spout-task/hardware/spout_holder/README.md

# Spout holder

Small printed blocks that hold the stainless steel lick spout(s) and attach them to an optical post on
the motorized manipulator, and a laser cut plate that holds the two solenoid valves of the water line.

<p align="center">
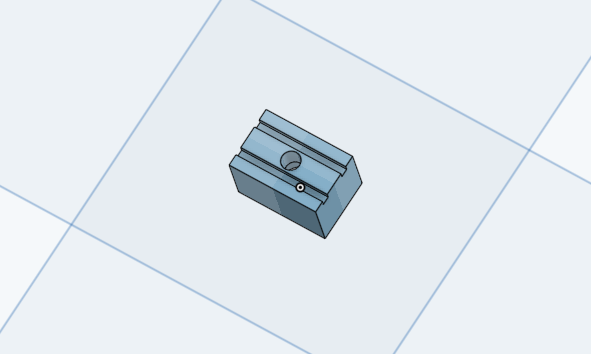
[picture p11: spout_holder/design/pictures/water_spout_bottom_mount.png]
Bottom mount spout holder
  
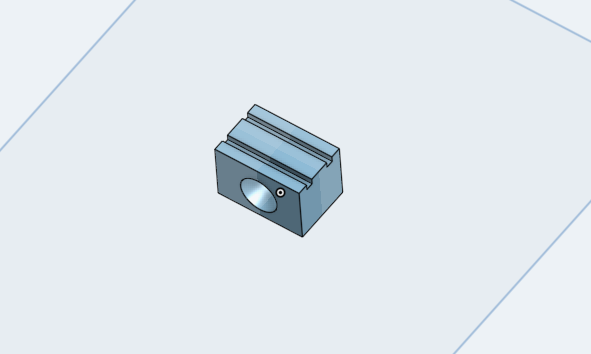
[picture p12: spout_holder/design/pictures/water_spout_side_mount.png]
Side mount spout holder
  
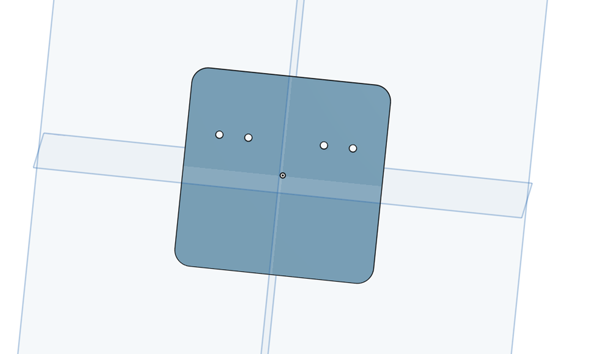
[picture p13: spout_holder/design/pictures/dual_solenoid_holder.png]
Dual solenoid holder
  
</p>

## At a glance

| | |
|---|---|
| Function | Holds one or two lick spouts in front of the mouse, and the two solenoid valves |
| Fabrication | Spout holders 3D printed (Prusa MK3, PLA, standard settings); solenoid holder laser cut from 1/8 inch acrylic |
| Used by | SPOUT1 and SPOUT2 (bottom mount); side mount for tight setups |

## Files

All design files are in [`design/files`](design/files/) and renders in [`design/pictures`](design/pictures/).

| Part | Files | What it is | How we made it |
|---|---|---|---|
| Bottom mount spout holder | [`.stl`](design/files/water_spout_bottom_mount.stl), [`.step`](design/files/water_spout_bottom_mount.step) | Holder mounted from below; used on SPOUT1 and SPOUT2 rigs | 3D printed, PLA |
| Side mount spout holder | [`.stl`](design/files/water_spout_side_mount.stl), [`.step`](design/files/water_spout_side_mount.step) | Holder mounted from the side, for setups with little space | 3D printed, PLA |
| Dual solenoid holder | [`.dxf`](design/files/dual_solenoid_holder.dxf), [`.stl`](design/files/dual_solenoid_holder.stl), [`.step`](design/files/dual_solenoid_holder.step) | Plate that holds the two solenoid valves | Laser cut, 1/8 inch acrylic |

The solenoid holder can also be 3D printed from the STL file. The STEP file is for editing in CAD.

## Bill of materials (water delivery)

| Qty | Part | Supplier | Part number | Price (USD) |
|---|---|---|---|---|
| 1 | 3D printed spout holder | | | |
| 1 | Stainless steel tube for the spouts | McMaster-Carr | 5560K72 | 3.90 |
| 2 | Syringe 30 ml (water reservoir) | BD Medical | 302832 | 0.32 each |
| 2 | Syringe 5 ml (flushing) | BD Medical | 309646 | 0.18 each |
| 2 | 3 way valve | Cole Parmer | 48523-38 | 1.01 each |
| 2 | Solenoid valve, 5 V | The Lee Company | LHQA0531220H | 65.60 each |
| 10 | Tubing, ID 1/16 inch, OD 1/8 inch | Tygon | E-3603 | 0.28 each |
| 1 | Pedestal post holder | Thorlabs | PH1 | 8.74 |
| 1 | Optical post | Thorlabs | TR6 | 8.66 |
| 2 | Cage rods | Thorlabs | ER3-P4 | 7.26 each |
| 1 | Swivel post | Thorlabs | MSWC | 40.80 |
| 1 | Dual solenoid holder, laser cut 1/8 inch acrylic | | | |

Full list: [`SPOUT_BOM.xlsx`](../SPOUT_BOM.xlsx).

## Assembly

1. Solder a wire to each stainless steel tube (spout), which will pull down the current of the dual-lick detector to detect licks. Make sure to solder a banana plug to the negative terminal to connect to the tube and headplate the holds the mouse.
2. Press fit the stainless steel tubes (spouts) into the holder and secure with a little glue.
3. Mount the holder on an optical post on the [motorized manipulator](../motorized_manipulator/).
4. Mount the two solenoids on the dual solenoid holder with four 4-40 screws.
5. The solenoid connection scheme: Top connector input from 30 ml reservoir, middle connector output to spout, bottom connector close by using some tubing with a zip tie. Power (left pin facing the solenoid from the connections should go to the left PCB connector on the Teensy breakout board) should go to the Teensy breakout board SLN1 or SLN2.
6. Use the 3-way valve to connect the 5 ml syringe to one side, the 30 ml syringe to the top side, and the solenoid to the other side. The 30 ml syringe is the reservoir, the 5 ml syringe is used to flush and prepare the tubing with reward, and the 3-way valve is to switch between them.
7. Connect each spout to the [dual lick detector](../dual_lick_detector/) and each solenoid to the [Teensy breakout board](../teensy_breakout_board/).

Photos of the build process will be added.

## License
**CERN-OHL-S-2.0** ([`LICENSE`](../LICENSE)).
