spout-task/hardware/motorized_manipulator/schematics/README.md

# Motorized manipulator: schematics

Schematics of the linear stage and of the stepper motor driver and controller. Click a picture to open it at full size.

Back to the [Motorized manipulator README](../README.md).

<table>
<tr>
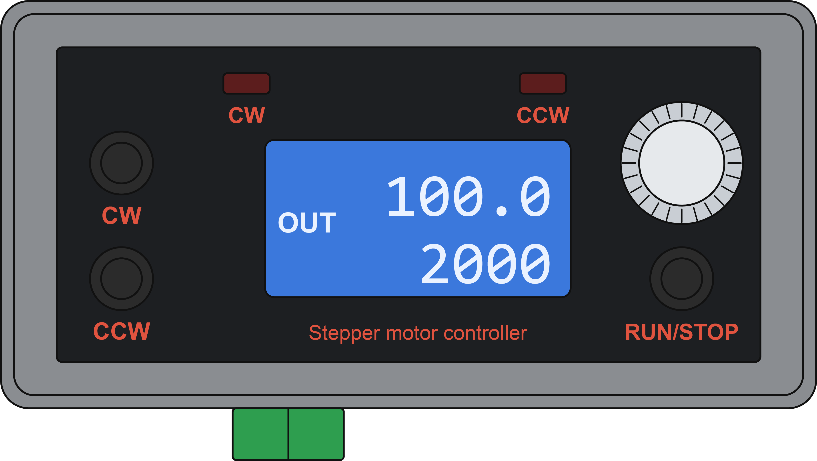
[picture p20: motorized_manipulator/schematics/driver_1.png]
Front panel of the driver and controller
<td width="50%" align="center" valign="top"><br><code>driver_1.png</code><br>Front panel of the driver and controller</td>
<td width="50%" align="center" valign="top"><a href="driver_2.png">Front panel with every button, indicator and the speed knob labelled</a><br><code>driver_2.png</code><br>Front panel with every button, indicator and the speed knob labelled</td>
</tr>
<tr>
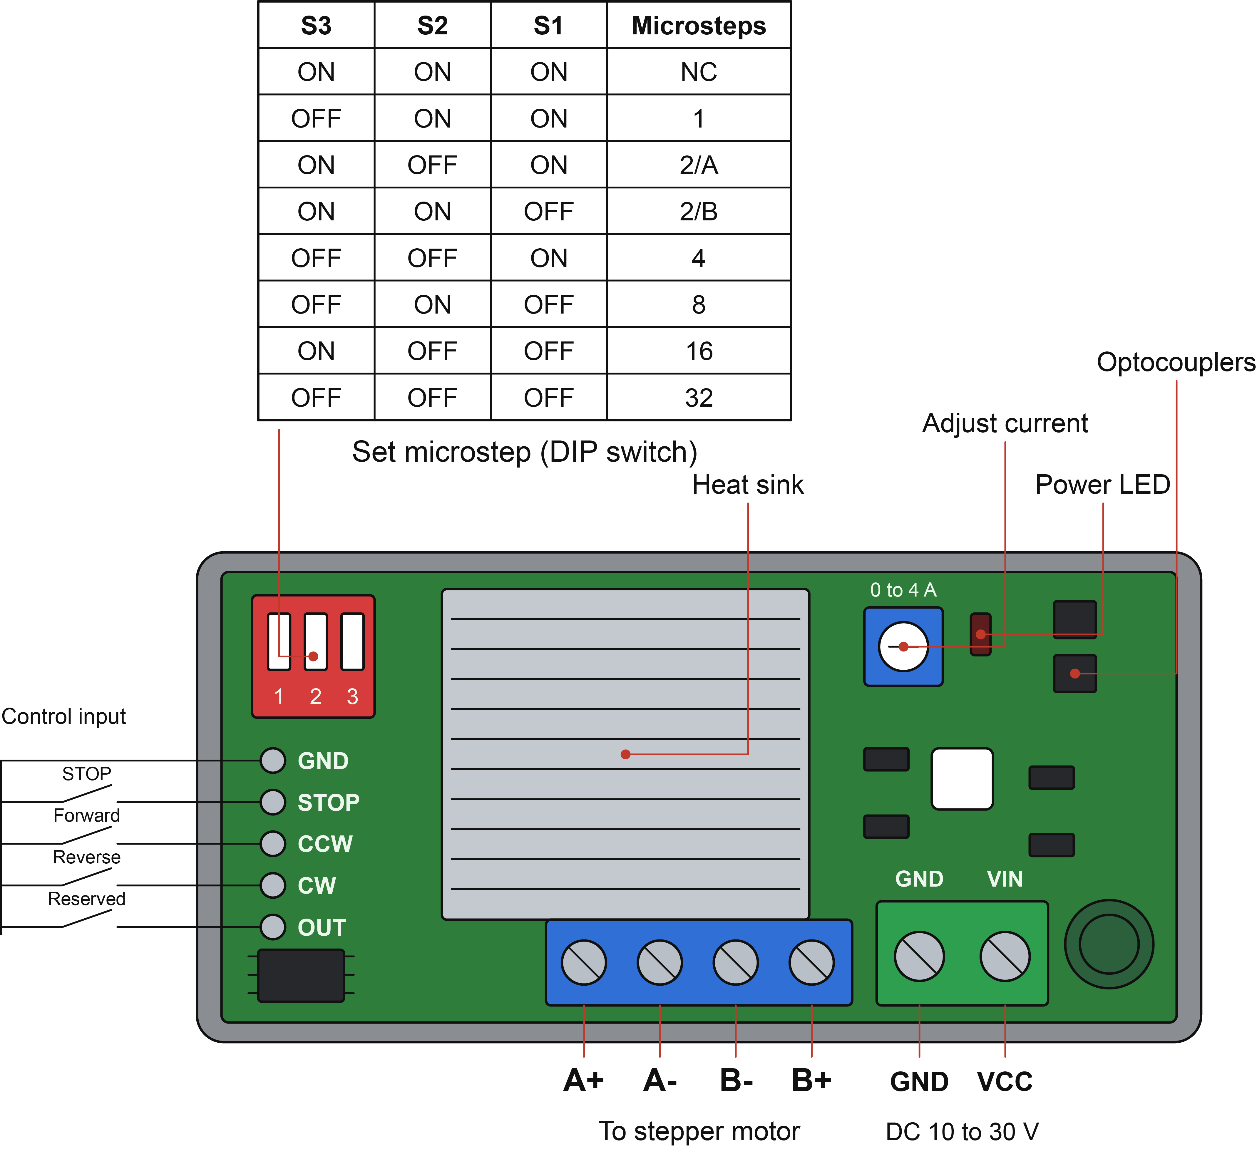
[picture p21: motorized_manipulator/schematics/driver_3.png]
Driver board: microstep DIP switch table, current adjustment, control inputs, motor and power terminals
<td width="50%" align="center" valign="top"><br><code>driver_3.png</code><br>Driver board: microstep DIP switch table, current adjustment, control inputs, motor and power terminals</td>
<td width="50%" align="center" valign="top"><a href="driver_4.png">Wiring of the stepper motor and the 24 V supply to the driver</a><br><code>driver_4.png</code><br>Wiring of the stepper motor and the 24 V supply to the driver</td>
</tr>
<tr>
<td width="50%" align="center" valign="top"><a href="track_1.png">Linear stage, top and side view with dimensions in mm</a><br><code>track_1.png</code><br>Linear stage, top and side view with dimensions in mm</td>
<td width="50%" align="center" valign="top"><a href="track_2.png">Linear stage with the stepper motor lead colors</a><br><code>track_2.png</code><br>Linear stage with the stepper motor lead colors</td>
</tr>
</table>
