spout-task/hardware/motorized_manipulator/design/pictures/README.md

# Motorized manipulator: design pictures

A photo of the assembled manipulator and renders of the 3D printed adapters, the drilling templates and the laser cut driver box. Click a picture to open it at full size.

Back to the [Motorized manipulator README](../../README.md).

## Photo

<table>
<tr>
<td width="50%" align="center" valign="top"><a href="motorized_manipulator.png">Assembled X, Y, Z manipulator with the post adapter</a><br><code>motorized_manipulator.png</code><br>Assembled X, Y, Z manipulator with the post adapter</td>
<td width="50%"></td>
</tr>
</table>

## Renders

<table>
<tr>
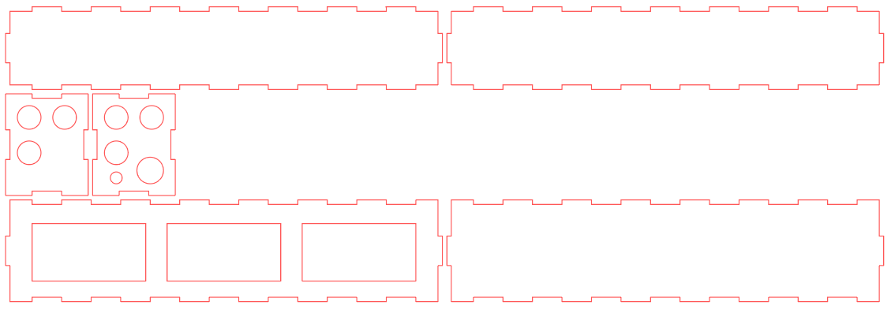
[picture p22: motorized_manipulator/design/pictures/box_mounting_steppermotor_drivers.png]
Laser cut box for the three drivers, cutting layout
<td width="50%" align="center" valign="top"><br><code>box_mounting_steppermotor_drivers.png</code><br>Laser cut box for the three drivers, cutting layout</td>
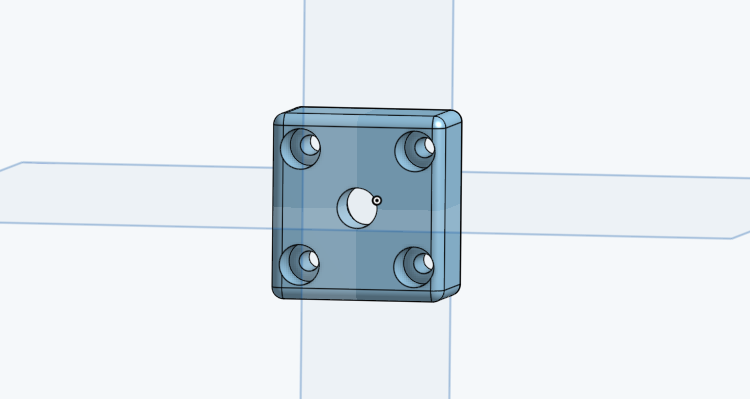
[picture p23: motorized_manipulator/design/pictures/micromanipulator_stage2postHalfInch1.png]
Adapter from the top stage to a 1/2 inch post, view 1
<td width="50%" align="center" valign="top"><br><code>micromanipulator_stage2postHalfInch1.png</code><br>Adapter from the top stage to a 1/2 inch post, view 1</td>
</tr>
<tr>
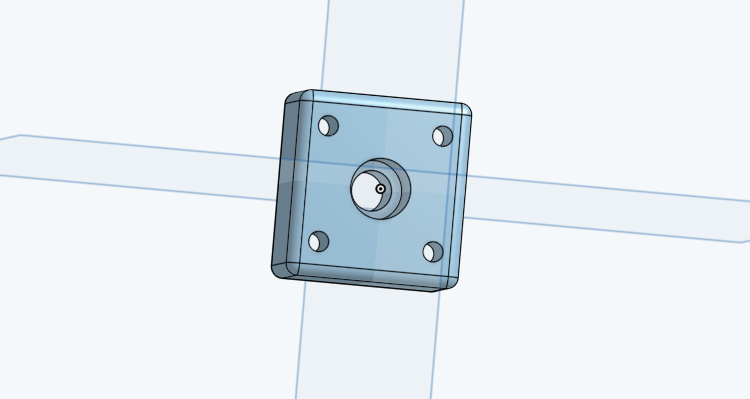
[picture p24: motorized_manipulator/design/pictures/micromanipulator_stage2postHalfInch2.png]
Adapter from the top stage to a 1/2 inch post, view 2
<td width="50%" align="center" valign="top"><br><code>micromanipulator_stage2postHalfInch2.png</code><br>Adapter from the top stage to a 1/2 inch post, view 2</td>
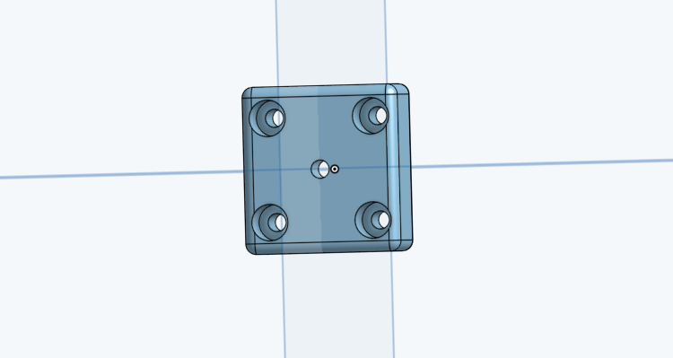
[picture p25: motorized_manipulator/design/pictures/micromanipulator_stage2postQuarterInch1.png]
Adapter from the top stage to a 1/4 inch post, view 1
<td width="50%" align="center" valign="top"><br><code>micromanipulator_stage2postQuarterInch1.png</code><br>Adapter from the top stage to a 1/4 inch post, view 1</td>
</tr>
<tr>
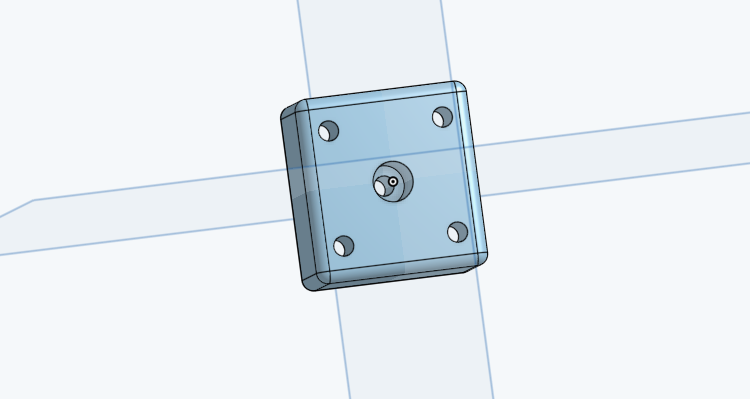
[picture p26: motorized_manipulator/design/pictures/micromanipulator_stage2postQuarterInch2.png]
Adapter from the top stage to a 1/4 inch post, view 2
<td width="50%" align="center" valign="top"><br><code>micromanipulator_stage2postQuarterInch2.png</code><br>Adapter from the top stage to a 1/4 inch post, view 2</td>
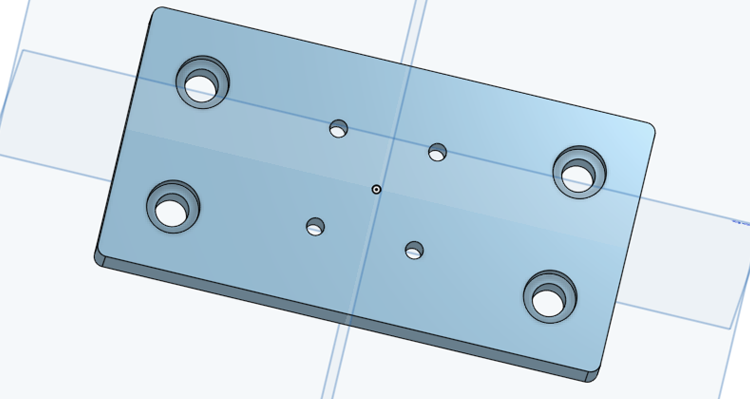
[picture p27: motorized_manipulator/design/pictures/micromanipulator_to_breadboard1.png]
Plate that mounts the bottom stage on the breadboard, view 1
<td width="50%" align="center" valign="top"><br><code>micromanipulator_to_breadboard1.png</code><br>Plate that mounts the bottom stage on the breadboard, view 1</td>
</tr>
<tr>
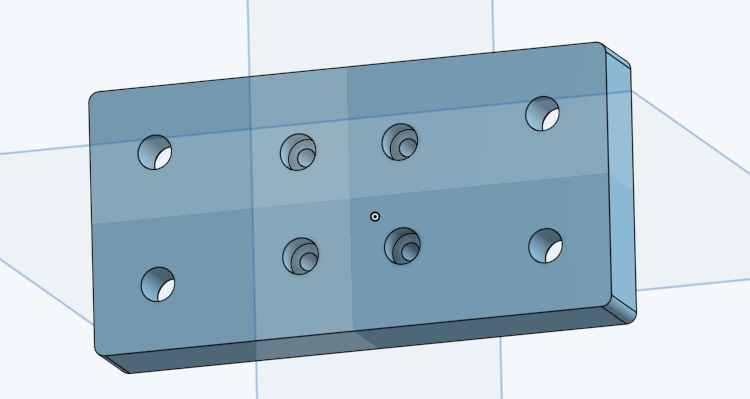
[picture p28: motorized_manipulator/design/pictures/micromanipulator_to_breadboard2.png]
Plate that mounts the bottom stage on the breadboard, view 2
<td width="50%" align="center" valign="top"><br><code>micromanipulator_to_breadboard2.png</code><br>Plate that mounts the bottom stage on the breadboard, view 2</td>
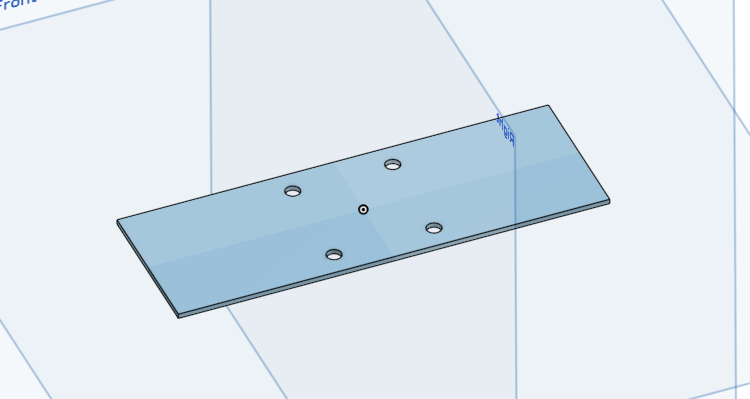
[picture p29: motorized_manipulator/design/pictures/template_linear_track_holes-10cm.png]
Drilling template, 10 cm
<td width="50%" align="center" valign="top"><br><code>template_linear_track_holes-10cm.png</code><br>Drilling template, 10 cm</td>
</tr>
<tr>
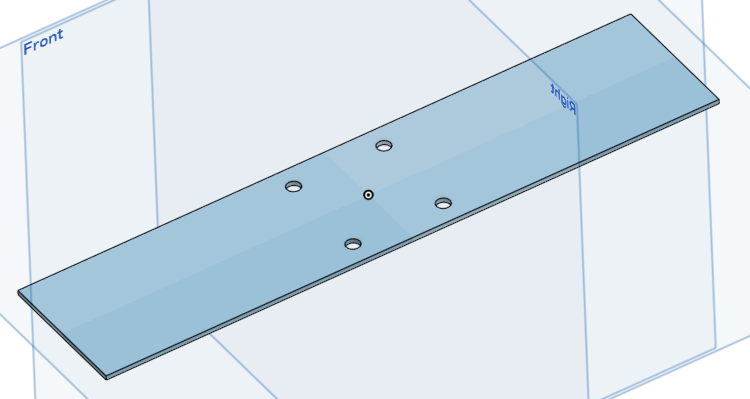
[picture p30: motorized_manipulator/design/pictures/template_linear_track_holes-5cm.png]
Drilling template, 5 cm
<td width="50%" align="center" valign="top"><br><code>template_linear_track_holes-5cm.png</code><br>Drilling template, 5 cm</td>
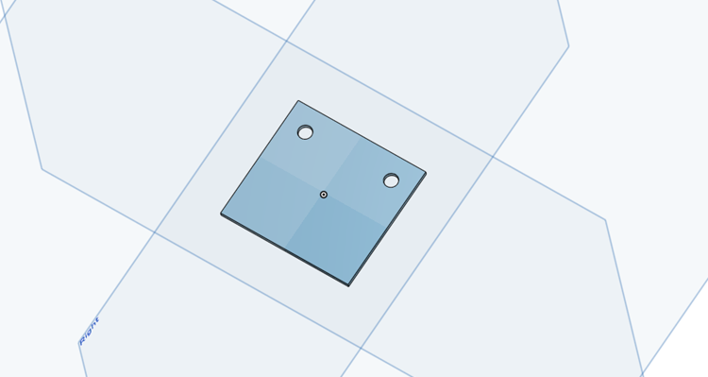
[picture p31: motorized_manipulator/design/pictures/template_linear_track_holes-edge.png]
Drilling template for the end plate of a stage
<td width="50%" align="center" valign="top"><br><code>template_linear_track_holes-edge.png</code><br>Drilling template for the end plate of a stage</td>
</tr>
</table>
