spout-task/hardware/dual_lick_detector/design/pictures/README.md

# Dual lick detector: design pictures

Render of the 3D printed housing. Click a picture to open it at full size.

Back to the [Dual lick detector README](../../README.md).

<table>
<tr>
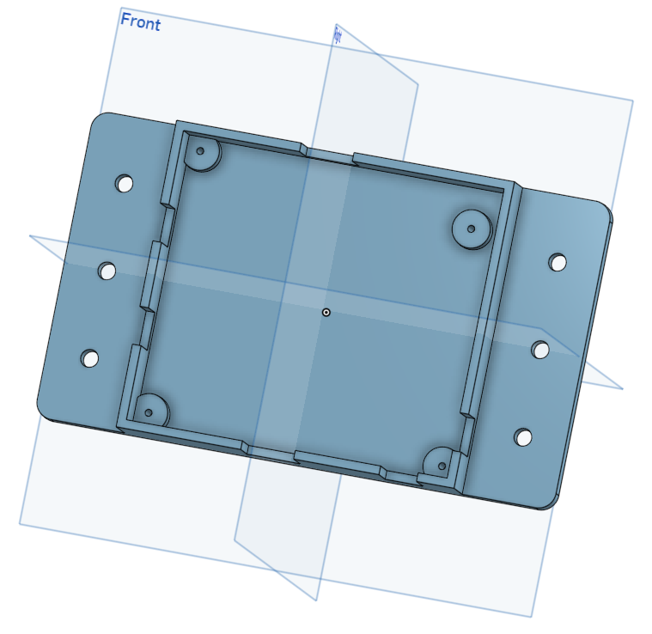
[picture p32: dual_lick_detector/design/pictures/box_dual_lick_detector.png]
Housing, 152 x 89 x 20 mm
<td width="50%" align="center" valign="top"><br><code>box_dual_lick_detector.png</code><br>Housing, 152 x 89 x 20 mm</td>
<td width="50%"></td>
</tr>
</table>
