spout-task/hardware/housing_miscellaneous/design/pictures/README.md

# Miscellaneous housings: design pictures

Renders of the 3D printed housings. Click a picture to open it at full size.

Back to the [Miscellaneous housings README](../../README.md).

<table>
<tr>
<td width="50%" align="center" valign="top"><a href="box_drok_amplifier.png">Housing for the DROK audio amplifier</a><br><code>box_drok_amplifier.png</code><br>Housing for the DROK audio amplifier</td>
<td width="50%" align="center" valign="top"><a href="box_power_small_sparkfun_breadboard.png">Power box for a SparkFun Solderable Breadboard Mini</a><br><code>box_power_small_sparkfun_breadboard.png</code><br>Power box for a SparkFun Solderable Breadboard Mini</td>
</tr>
</table>
