spout-task/hardware/optogenetics_power_modulator/design/pictures/README.md

# Optogenetics power modulator: design pictures

Render of the 3D printed housing. Click a picture to open it at full size.

Back to the [Optogenetics power modulator README](../../README.md).

<table>
<tr>
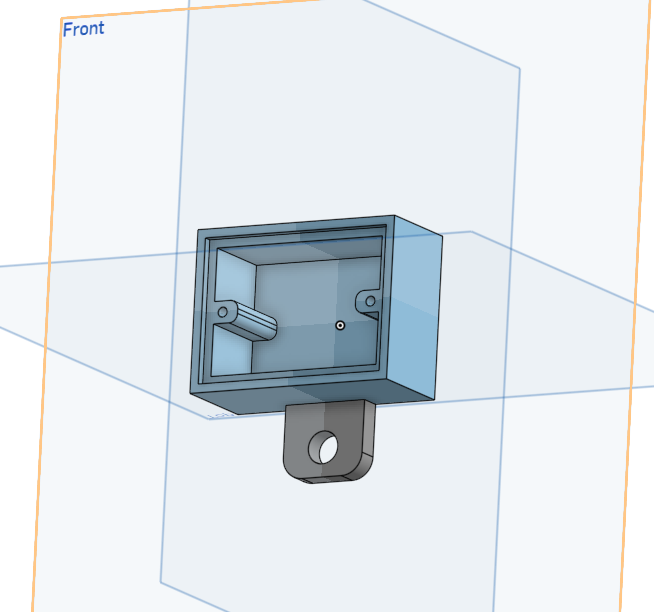
[picture p33: optogenetics_power_modulator/design/pictures/housing_opto_power_mod.png]
Housing, 50 x 54 x 22 mm
<td width="50%" align="center" valign="top"><br><code>housing_opto_power_mod.png</code><br>Housing, 50 x 54 x 22 mm</td>
<td width="50%"></td>
</tr>
</table>
