spout-task/hardware/spout_holder/design/pictures/README.md

# Spout holder: design pictures

Renders of the spout holders and the dual solenoid holder. Click a picture to open it at full size.

Back to the [Spout holder README](../../README.md).

<table>
<tr>
<td width="50%" align="center" valign="top"><a href="dual_solenoid_holder.png">Dual solenoid holder</a><br><code>dual_solenoid_holder.png</code><br>Dual solenoid holder</td>
<td width="50%" align="center" valign="top"><a href="water_spout_bottom_mount.png">Spout holder, bottom mount</a><br><code>water_spout_bottom_mount.png</code><br>Spout holder, bottom mount</td>
</tr>
<tr>
<td width="50%" align="center" valign="top"><a href="water_spout_side_mount.png">Spout holder, side mount</a><br><code>water_spout_side_mount.png</code><br>Spout holder, side mount</td>
<td width="50%"></td>
</tr>
</table>
