spout-task/hardware/teensy_breakout_board/design/pictures/README.md

# Teensy breakout board: design pictures

Render of the 3D printed housing. Click a picture to open it at full size.

Back to the [Teensy breakout board README](../../README.md).

<table>
<tr>
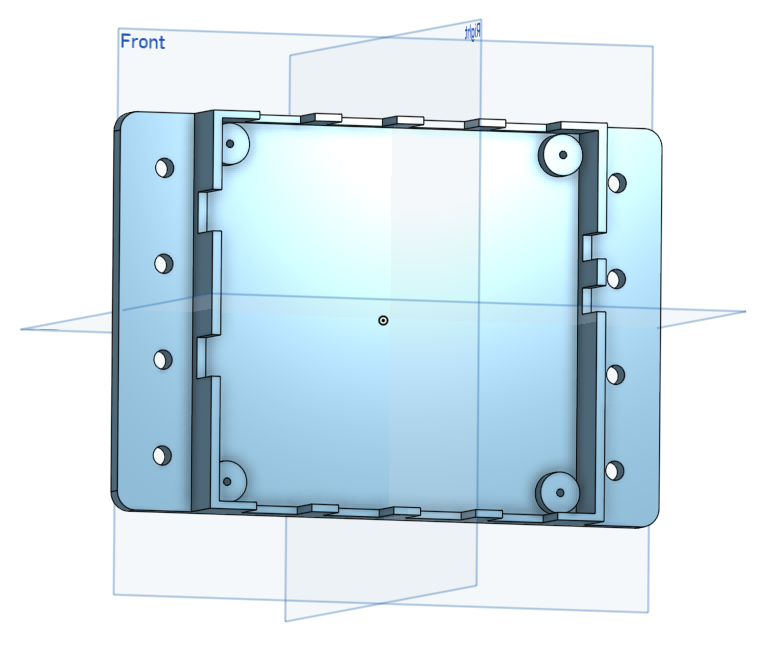
[picture p34: teensy_breakout_board/design/pictures/box_teensy_breakoutboard.png]
Housing, 152 x 106 x 20 mm
<td width="50%" align="center" valign="top"><br><code>box_teensy_breakoutboard.png</code><br>Housing, 152 x 106 x 20 mm</td>
<td width="50%"></td>
</tr>
</table>
