spout-task/hardware/optogenetics_power_modulator/circuit/pictures/README.md

# Optogenetics power modulator: circuit pictures

Photos of the circuit built on a SparkFun Solderable Breadboard Mini. Click a picture to open it at full size.

Back to the [Optogenetics power modulator README](../../README.md).

<table>
<tr>
<td width="50%" align="center" valign="top"><a href="opto_power_mod0.png">Circuit in the 3D printed housing with the BNC output, top view</a><br><code>opto_power_mod0.png</code><br>Circuit in the 3D printed housing with the BNC output, top view</td>
<td width="50%"></td>
</tr>
<tr>
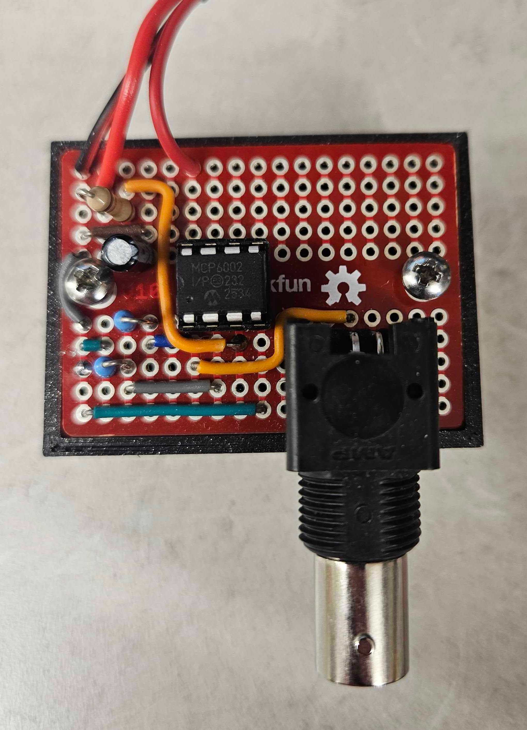
[picture p35: optogenetics_power_modulator/circuit/pictures/opto_power_mod1.png]
Circuit in the 3D printed housing, top view
<td width="50%" align="center" valign="top"><br><code>opto_power_mod1.png</code><br>Circuit in the 3D printed housing, top view</td>
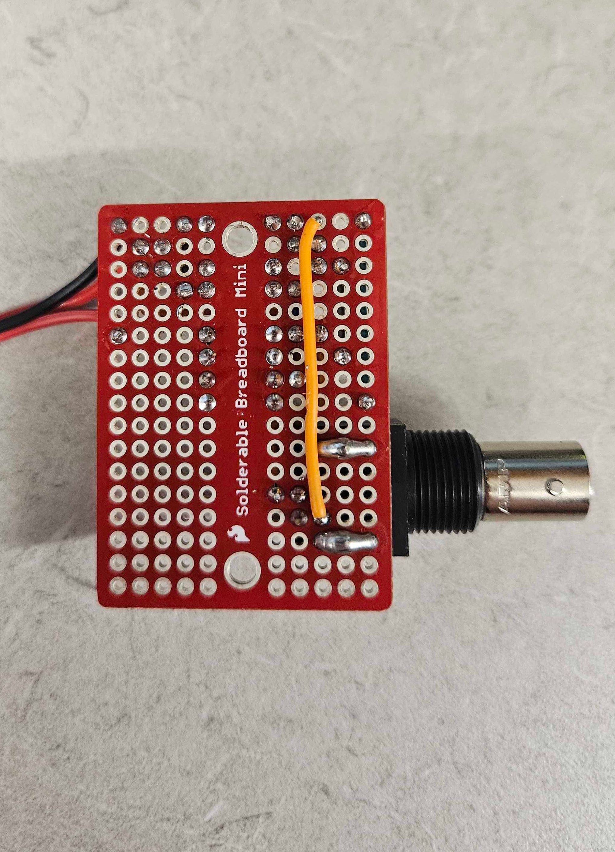
[picture p36: optogenetics_power_modulator/circuit/pictures/opto_power_mod2.png]
Circuit, bottom view
<td width="50%" align="center" valign="top"><br><code>opto_power_mod2.png</code><br>Circuit, bottom view</td>
</tr>
<tr>
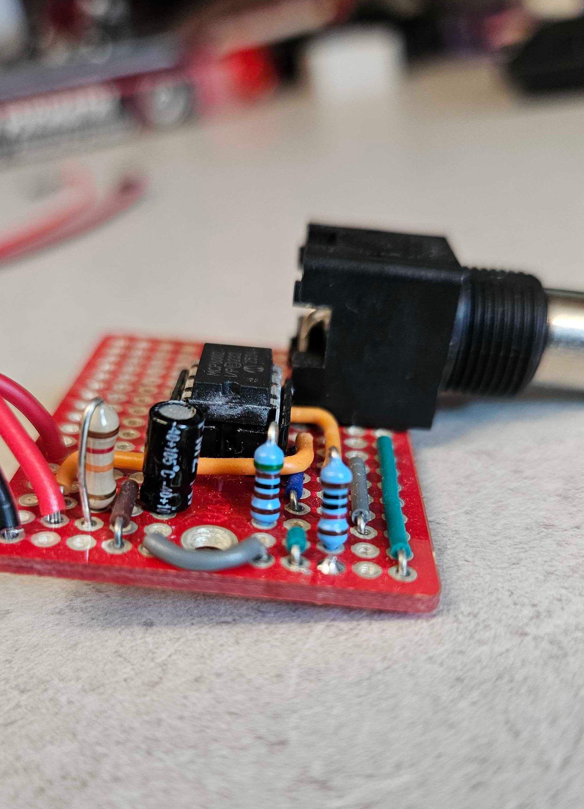
[picture p37: optogenetics_power_modulator/circuit/pictures/opto_power_mod3.png]
Circuit, side view
<td width="50%" align="center" valign="top"><br><code>opto_power_mod3.png</code><br>Circuit, side view</td>
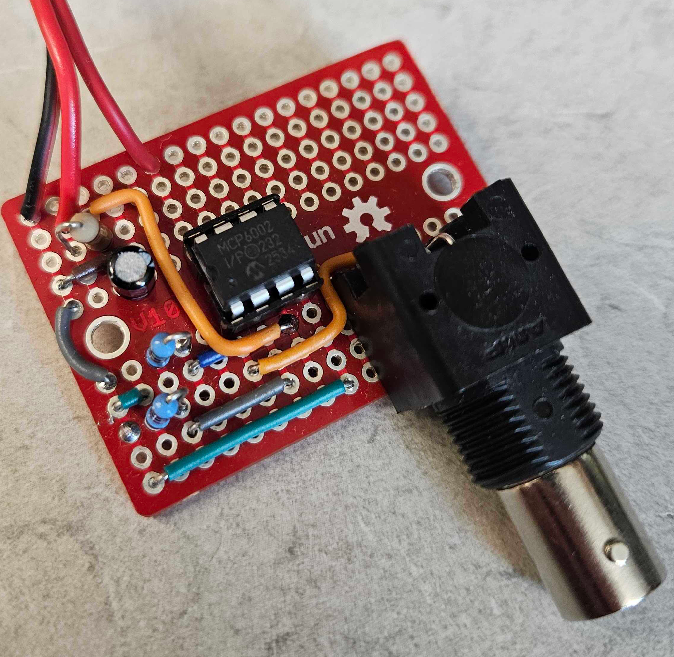
[picture p38: optogenetics_power_modulator/circuit/pictures/opto_power_mod4.png]
Circuit with BNC connector, angled view
<td width="50%" align="center" valign="top"><br><code>opto_power_mod4.png</code><br>Circuit with BNC connector, angled view</td>
</tr>
</table>
