spout-task/hardware/dual_lick_detector/PCB/pictures/README.md

# Dual lick detector: PCB pictures

Photos and KiCad renders of the board, revision Alpha1e. Click a picture to open it at full size.

Back to the [Dual lick detector README](../../README.md).

<table>
<tr>
<td width="50%" align="center" valign="top"><a href="dual_lick_detector_1.jpg">Assembled board with BNC connectors, potentiometers and battery holder</a><br><code>dual_lick_detector_1.jpg</code><br>Assembled board with BNC connectors, potentiometers and battery holder</td>
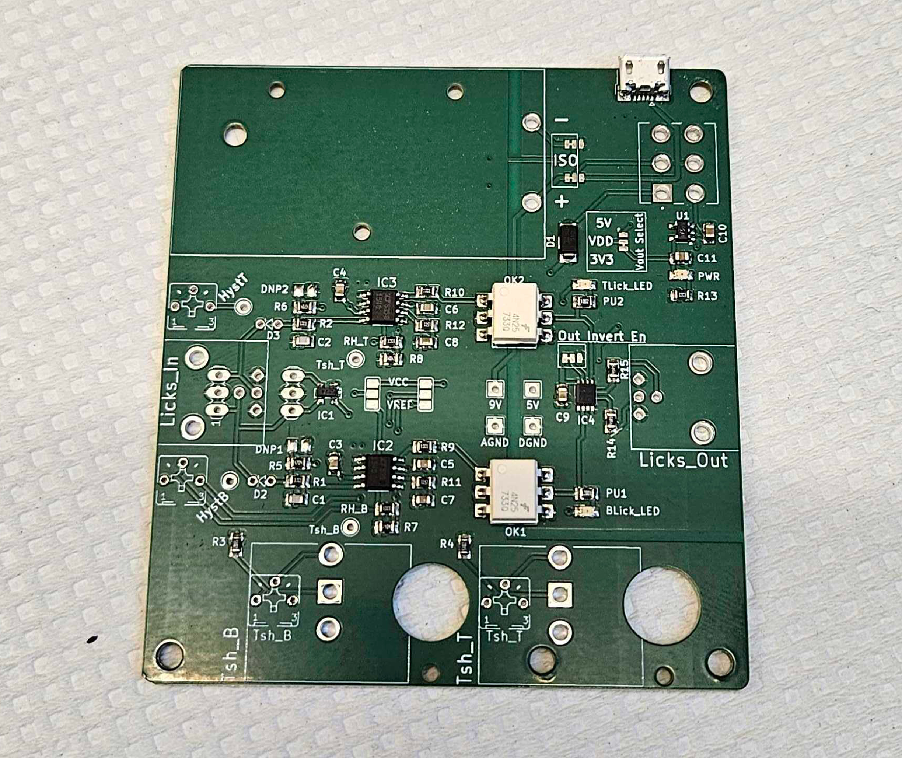
[picture p39: dual_lick_detector/PCB/pictures/dual_lick_detector_2.jpg]
Bare board, top
<td width="50%" align="center" valign="top"><br><code>dual_lick_detector_2.jpg</code><br>Bare board, top</td>
</tr>
<tr>
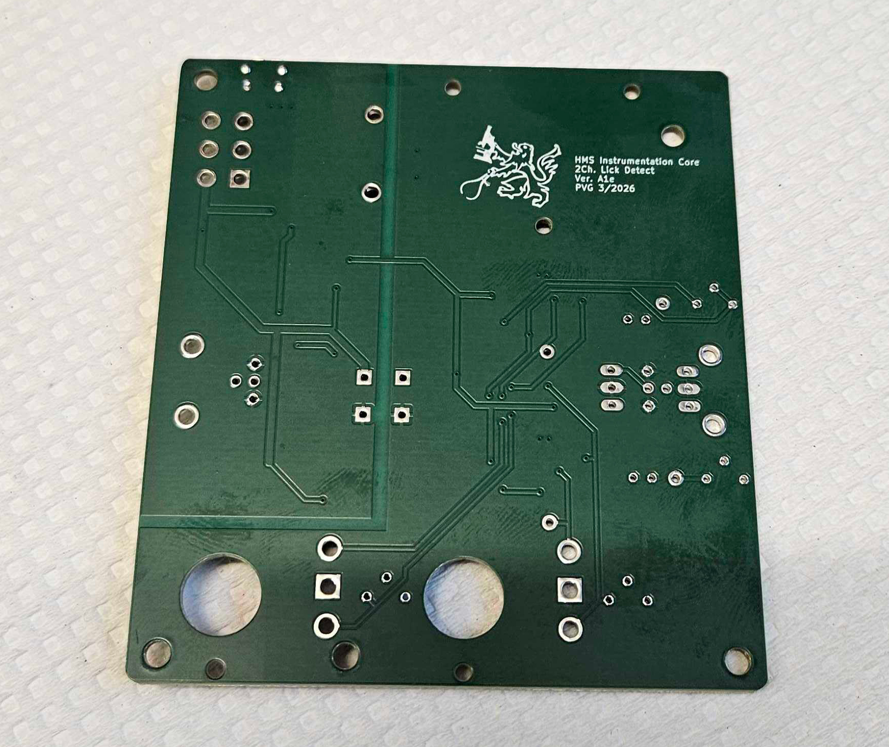
[picture p40: dual_lick_detector/PCB/pictures/dual_lick_detector_3.jpg]
Bare board, bottom
<td width="50%" align="center" valign="top"><br><code>dual_lick_detector_3.jpg</code><br>Bare board, bottom</td>
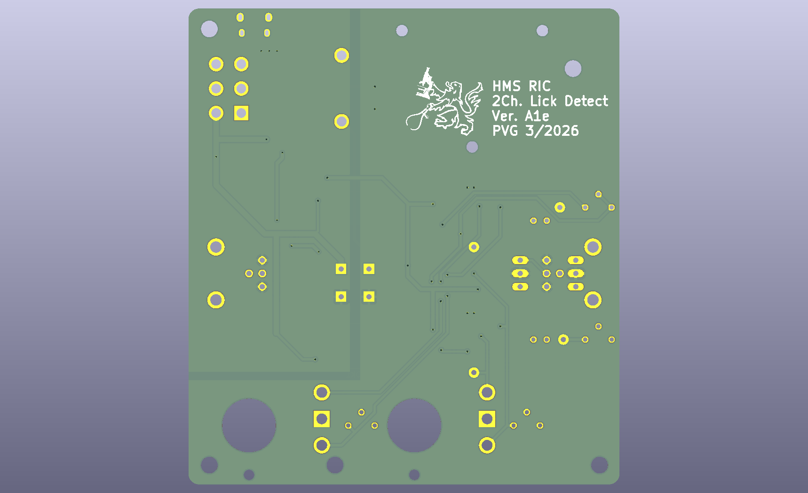
[picture p41: dual_lick_detector/PCB/pictures/dual_lick_detector_schematic_1.png]
KiCad render, bottom
<td width="50%" align="center" valign="top"><br><code>dual_lick_detector_schematic_1.png</code><br>KiCad render, bottom</td>
</tr>
<tr>
<td width="50%" align="center" valign="top"><a href="dual_lick_detector_schematic_2.png">KiCad render, top</a><br><code>dual_lick_detector_schematic_2.png</code><br>KiCad render, top</td>
<td width="50%"></td>
</tr>
</table>
