spout-task/hardware/optogenetics_power_modulator/circuit/files/README.md

# Optogenetics power modulator: circuit diagram

Circuit diagram. Click a picture to open it at full size.

Back to the [Optogenetics power modulator README](../../README.md).

<table>
<tr>
<td width="50%" align="center" valign="top"><a href="opto_power_mod.png">Circuit: Teensy PWM, RC filter, MCP6002 amplifier, BNC output</a><br><code>opto_power_mod.png</code><br>Circuit: Teensy PWM, RC filter, MCP6002 amplifier, BNC output</td>
<td width="50%"></td>
</tr>
</table>
