spout-task/hardware/teensy_breakout_board/PCB/pictures/README.md

# Teensy breakout board: PCB pictures

Photos and KiCad renders of the board, revision Alpha1b. Click a picture to open it at full size.

Back to the [Teensy breakout board README](../../README.md).

<table>
<tr>
<td width="50%" align="center" valign="top"><a href="Teensy_breakout_board_1.jpg">Assembled board with the Teensy 4.1 and eight BNC connectors</a><br><code>Teensy_breakout_board_1.jpg</code><br>Assembled board with the Teensy 4.1 and eight BNC connectors</td>
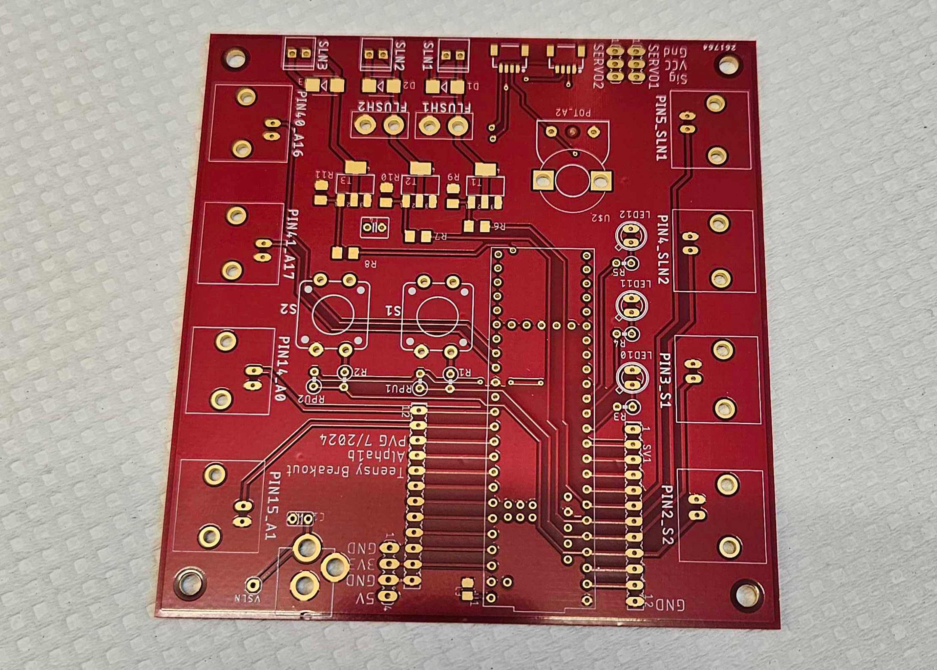
[picture p42: teensy_breakout_board/PCB/pictures/Teensy_breakout_board_2.jpg]
Bare board, top
<td width="50%" align="center" valign="top"><br><code>Teensy_breakout_board_2.jpg</code><br>Bare board, top</td>
</tr>
<tr>
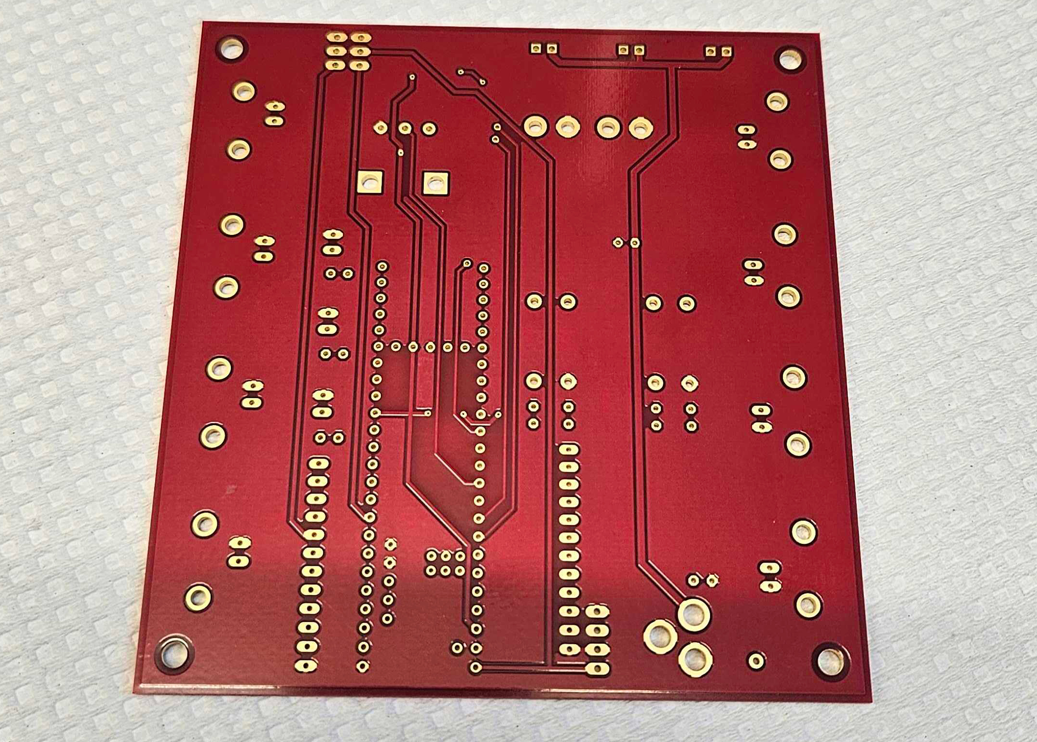
[picture p43: teensy_breakout_board/PCB/pictures/Teensy_breakout_board_3.jpg]
Bare board, bottom
<td width="50%" align="center" valign="top"><br><code>Teensy_breakout_board_3.jpg</code><br>Bare board, bottom</td>
<td width="50%" align="center" valign="top"><a href="Teensy_breakout_board_schematic_1.png">KiCad render, top</a><br><code>Teensy_breakout_board_schematic_1.png</code><br>KiCad render, top</td>
</tr>
<tr>
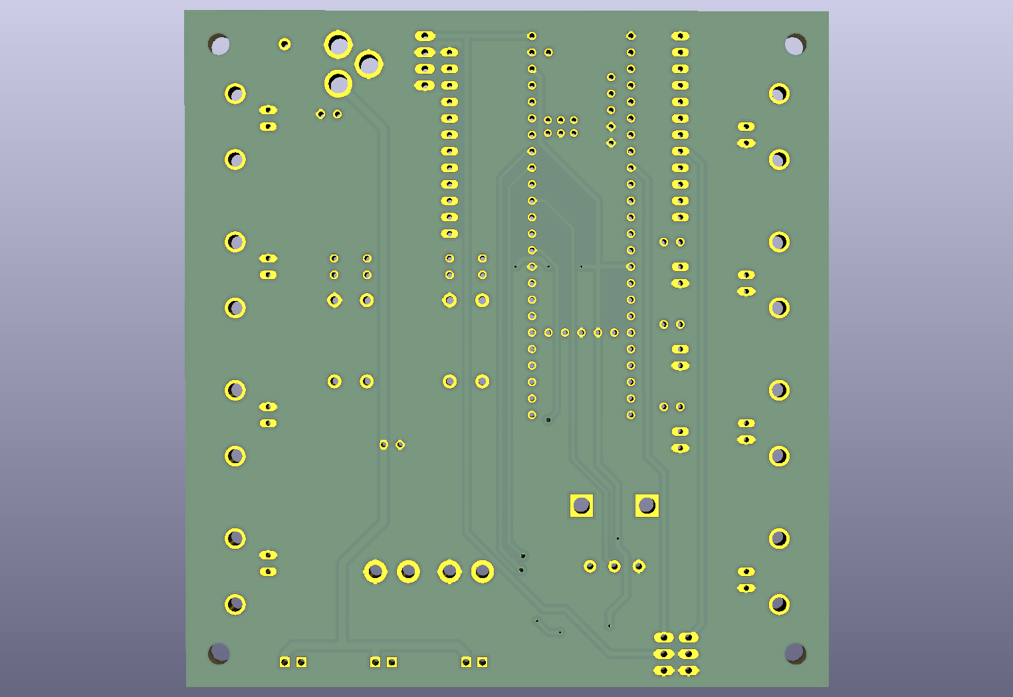
[picture p44: teensy_breakout_board/PCB/pictures/Teensy_breakout_board_schematic_2.png]
KiCad render, bottom
<td width="50%" align="center" valign="top"><br><code>Teensy_breakout_board_schematic_2.png</code><br>KiCad render, bottom</td>
<td width="50%"></td>
</tr>
</table>
