spout-task/hardware/head-restrained_setup/design/pictures/README.md

# Head restrained setup: design pictures

Photos and renders of the headplates, holders, ramps, cone and cover. Click a picture to open it at full size.

Back to the [Head restrained setup README](../../README.md).

## Photos

<table>
<tr>
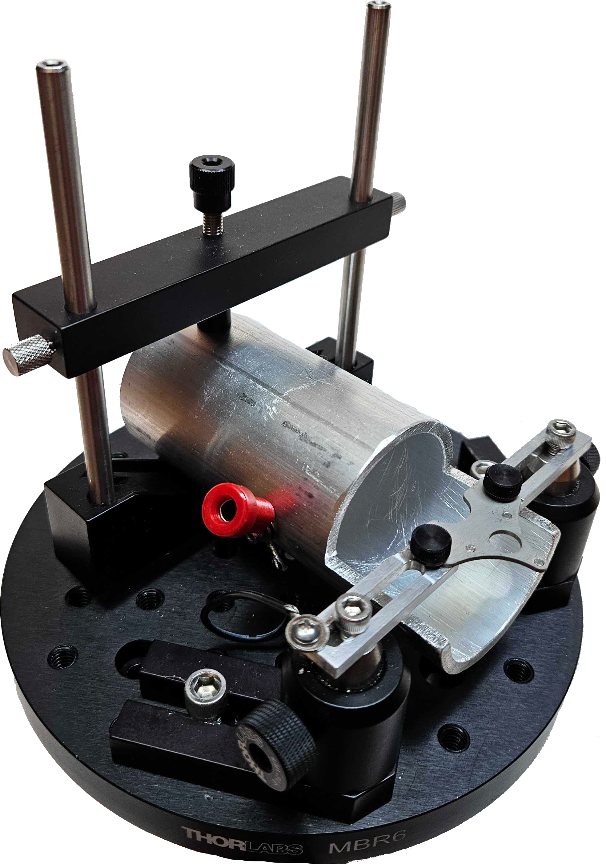
[picture p45: head-restrained_setup/design/pictures/head-restriction_setup_side.png]
Head restrained setup, side view
<td width="50%" align="center" valign="top"><br><code>head-restriction_setup_side.png</code><br>Head restrained setup, side view</td>
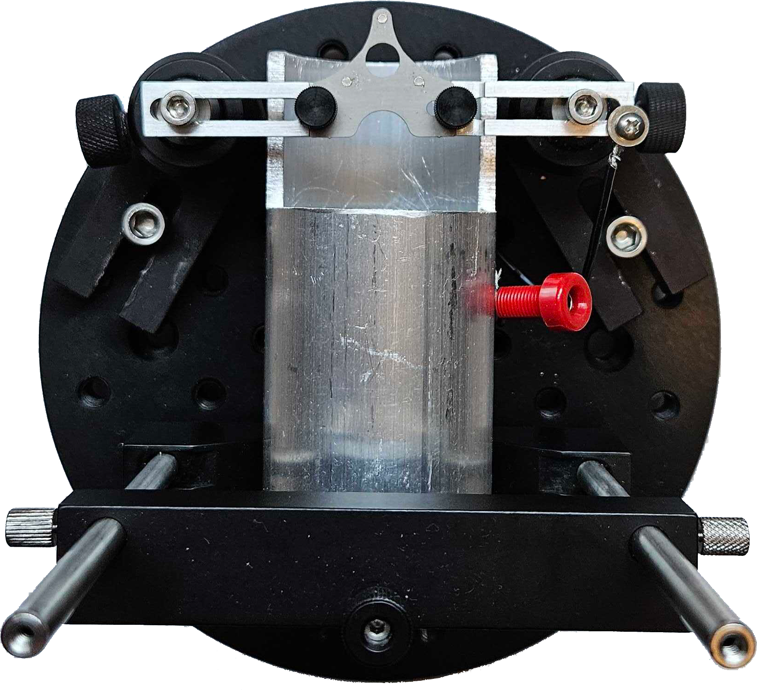
[picture p46: head-restrained_setup/design/pictures/head-restriction_setup_top.png]
Head restrained setup, top view
<td width="50%" align="center" valign="top"><br><code>head-restriction_setup_top.png</code><br>Head restrained setup, top view</td>
</tr>
<tr>
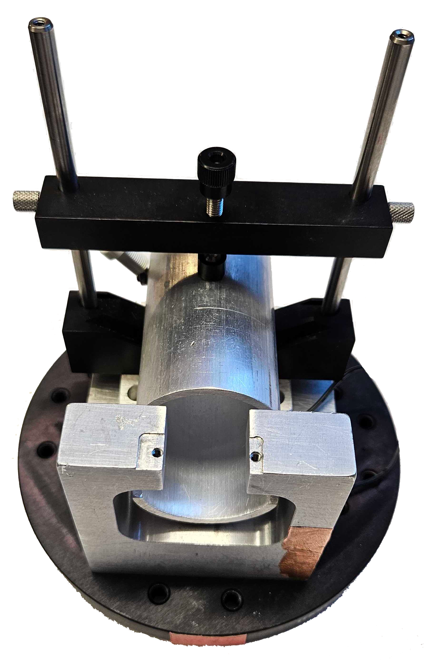
[picture p47: head-restrained_setup/design/pictures/head-restriction_setup_imaging.png]
Head restrained setup with the imaging holder
<td width="50%" align="center" valign="top"><br><code>head-restriction_setup_imaging.png</code><br>Head restrained setup with the imaging holder</td>
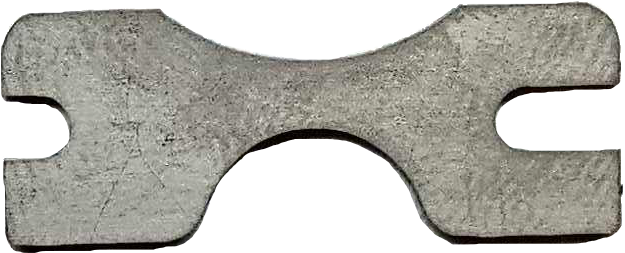
[picture p48: head-restrained_setup/design/pictures/headplate_behavior_photo.png]
Behavior headplate, titanium
<td width="50%" align="center" valign="top"><br><code>headplate_behavior_photo.png</code><br>Behavior headplate, titanium</td>
</tr>
<tr>
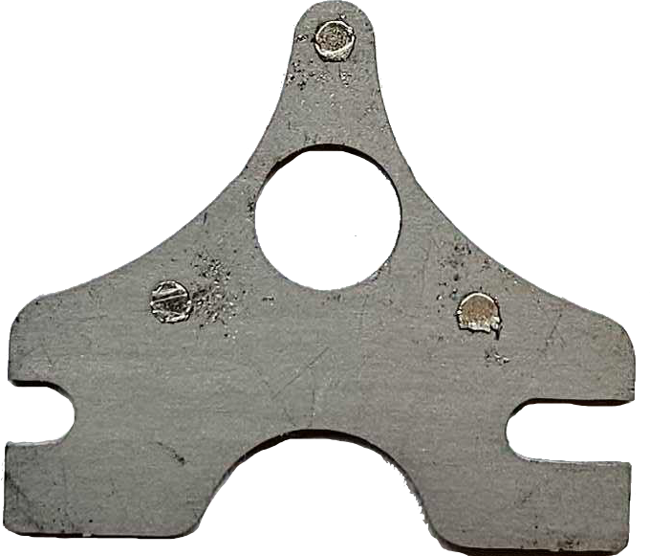
[picture p49: head-restrained_setup/design/pictures/headplate_2pimaging_photo.png]
Imaging headplate, titanium, with three magnets
<td width="50%" align="center" valign="top"><br><code>headplate_2pimaging_photo.png</code><br>Imaging headplate, titanium, with three magnets</td>
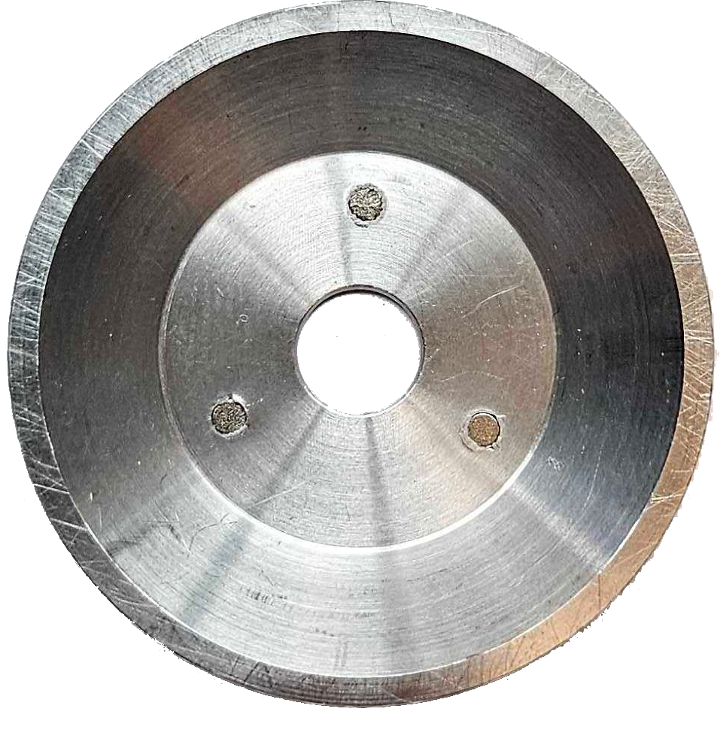
[picture p50: head-restrained_setup/design/pictures/headplate_2pimaging_cone_photo.png]
Imaging cone, aluminium, with three magnets
<td width="50%" align="center" valign="top"><br><code>headplate_2pimaging_cone_photo.png</code><br>Imaging cone, aluminium, with three magnets</td>
</tr>
</table>

## Renders

<table>
<tr>
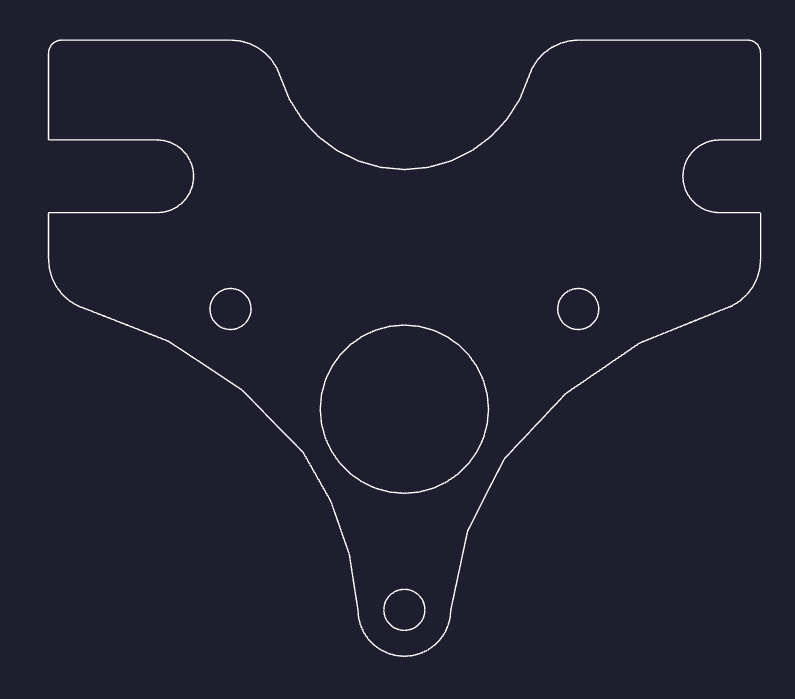
[picture p51: head-restrained_setup/design/pictures/headplate_2pimaging.png]
Imaging headplate
<td width="50%" align="center" valign="top"><br><code>headplate_2pimaging.png</code><br>Imaging headplate</td>
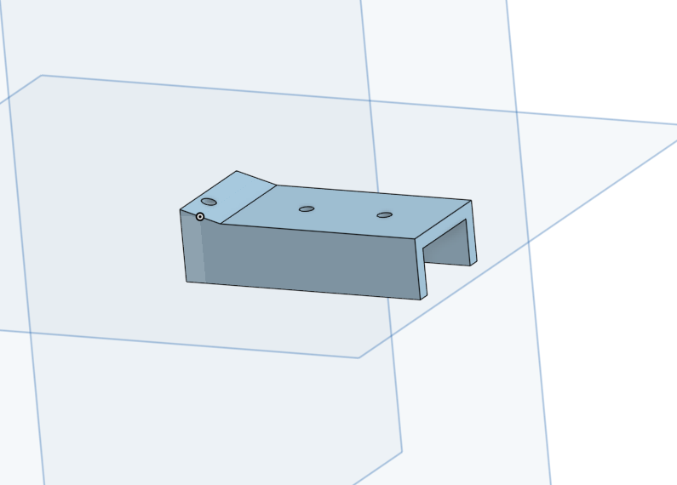
[picture p52: head-restrained_setup/design/pictures/headplate_2pimaging_15degreesramp_left.png]
Imaging ramp, 15 degrees, left
<td width="50%" align="center" valign="top"><br><code>headplate_2pimaging_15degreesramp_left.png</code><br>Imaging ramp, 15 degrees, left</td>
</tr>
<tr>
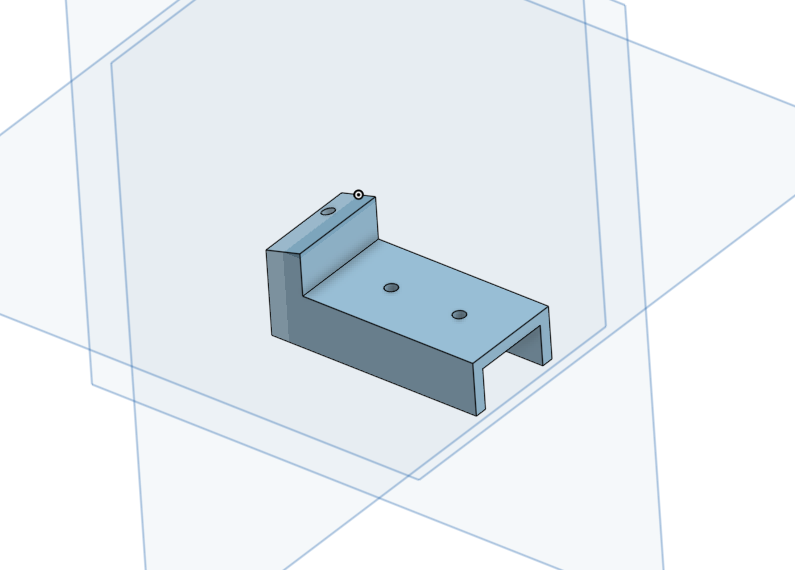
[picture p53: head-restrained_setup/design/pictures/headplate_2pimaging_15degreesramp_right.png]
Imaging ramp, 15 degrees, right
<td width="50%" align="center" valign="top"><br><code>headplate_2pimaging_15degreesramp_right.png</code><br>Imaging ramp, 15 degrees, right</td>
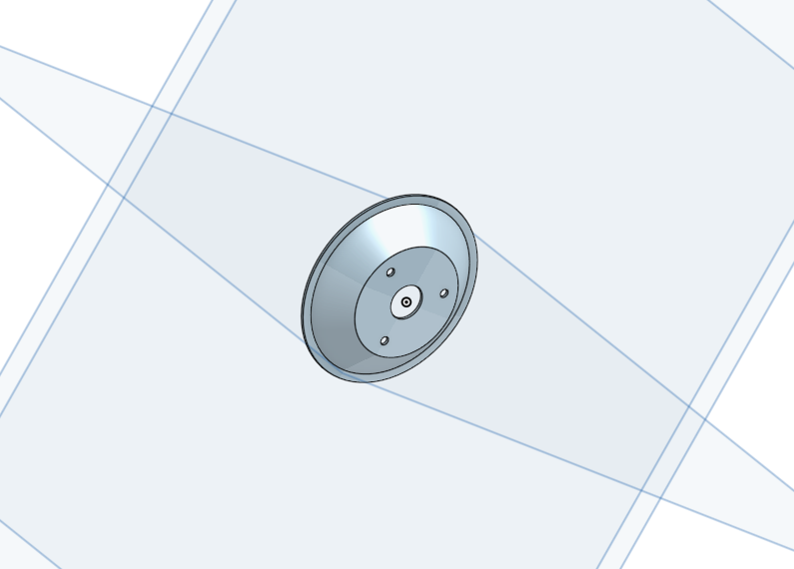
[picture p54: head-restrained_setup/design/pictures/headplate_2pimaging_cone.png]
Imaging cone
<td width="50%" align="center" valign="top"><br><code>headplate_2pimaging_cone.png</code><br>Imaging cone</td>
</tr>
<tr>
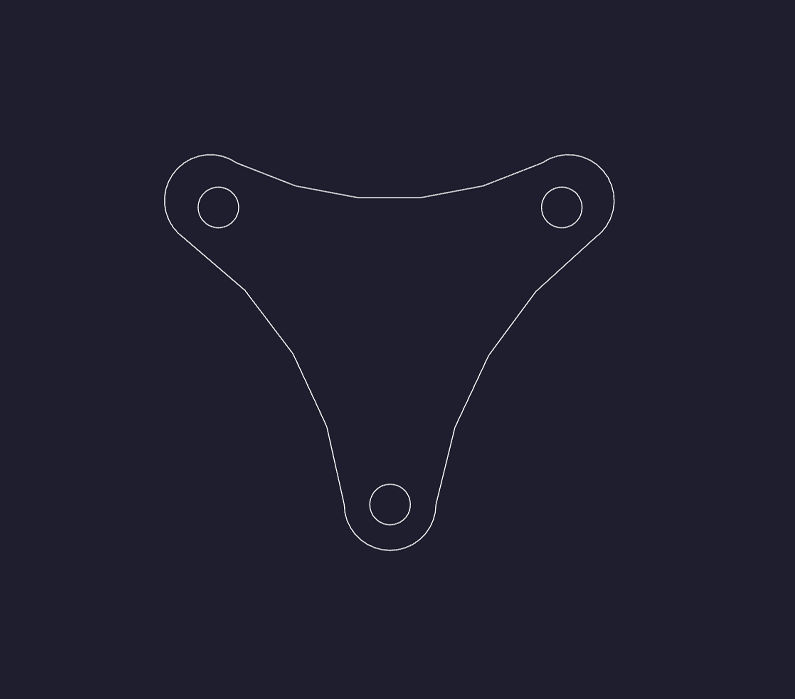
[picture p55: head-restrained_setup/design/pictures/headplate_2pimaging_cover.png]
Imaging cover
<td width="50%" align="center" valign="top"><br><code>headplate_2pimaging_cover.png</code><br>Imaging cover</td>
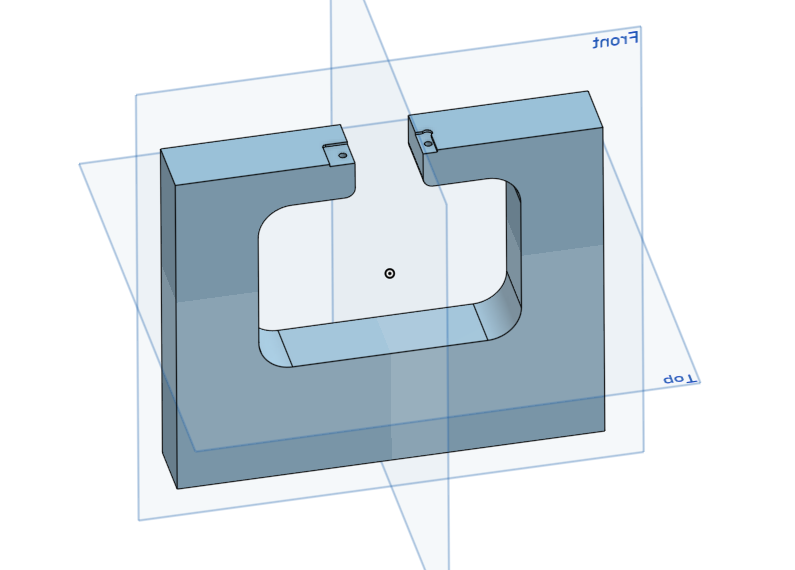
[picture p56: head-restrained_setup/design/pictures/headplate_2pimaging_holder_big1.png]
Imaging holder, view 1
<td width="50%" align="center" valign="top"><br><code>headplate_2pimaging_holder_big1.png</code><br>Imaging holder, view 1</td>
</tr>
<tr>
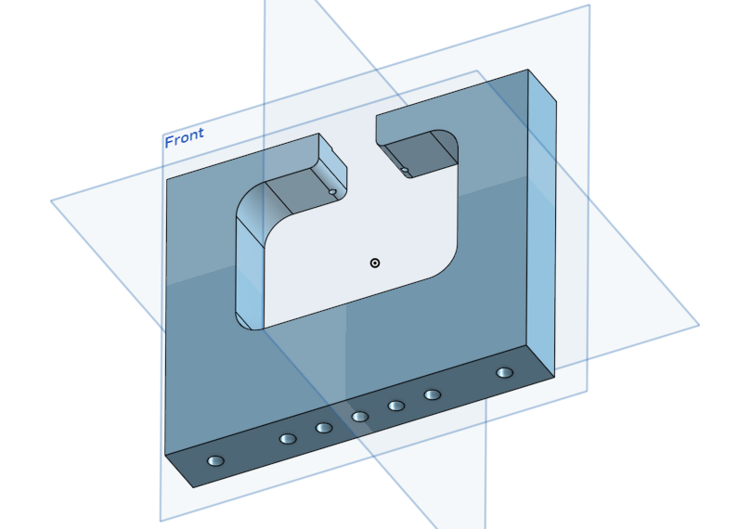
[picture p57: head-restrained_setup/design/pictures/headplate_2pimaging_holder_big2.png]
Imaging holder, view 2
<td width="50%" align="center" valign="top"><br><code>headplate_2pimaging_holder_big2.png</code><br>Imaging holder, view 2</td>
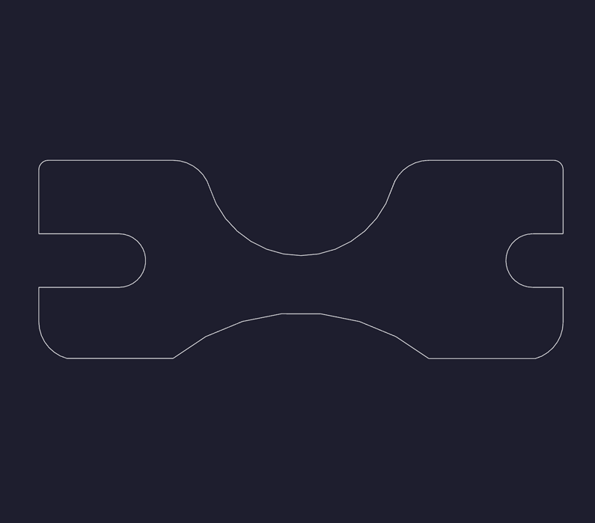
[picture p58: head-restrained_setup/design/pictures/headplate_behavior.png]
Behavior headplate
<td width="50%" align="center" valign="top"><br><code>headplate_behavior.png</code><br>Behavior headplate</td>
</tr>
<tr>
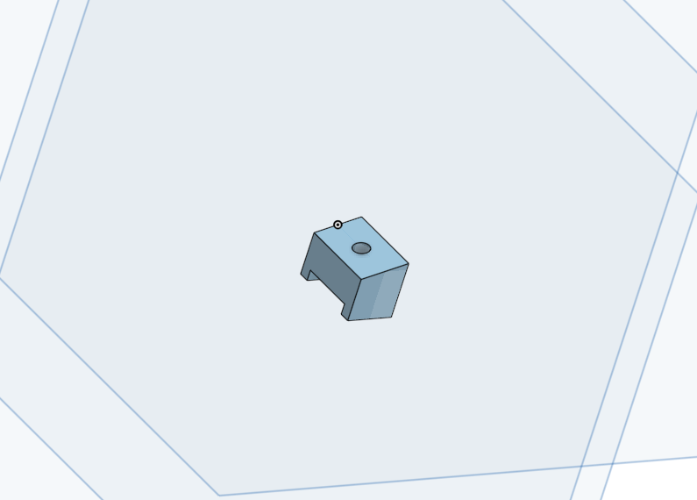
[picture p59: head-restrained_setup/design/pictures/headplate_behavior_15degreesramp_right.png]
Behavior ramp, 15 degrees, right
<td width="50%" align="center" valign="top"><br><code>headplate_behavior_15degreesramp_right.png</code><br>Behavior ramp, 15 degrees, right</td>
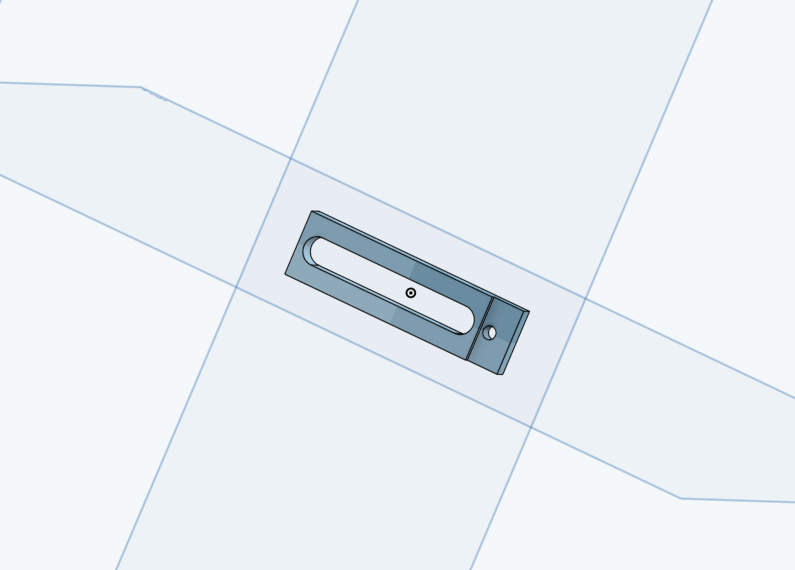
[picture p60: head-restrained_setup/design/pictures/headplate_behavior_holder_left.png]
Behavior holder, left
<td width="50%" align="center" valign="top"><br><code>headplate_behavior_holder_left.png</code><br>Behavior holder, left</td>
</tr>
<tr>
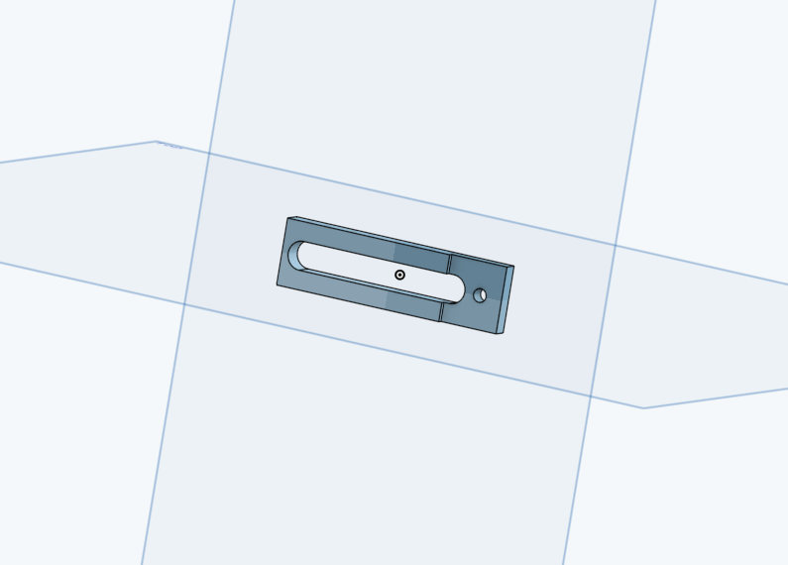
[picture p61: head-restrained_setup/design/pictures/headplate_behavior_holder_right.png]
Behavior holder, right
<td width="50%" align="center" valign="top"><br><code>headplate_behavior_holder_right.png</code><br>Behavior holder, right</td>
<td width="50%"></td>
</tr>
</table>
