spout-task/hardware/breadboards/design/pictures/README.md

# Breadboards: design pictures

Renders of the two breadboards. Click a picture to open it at full size.

Back to the [Breadboards README](../../README.md).

<table>
<tr>
<td width="50%" align="center" valign="top"><a href="breadboard_12x18.png">Rig breadboard, 12 x 18 inch</a><br><code>breadboard_12x18.png</code><br>Rig breadboard, 12 x 18 inch</td>
<td width="50%" align="center" valign="top"><a href="breadboard_headplate.png">Round breadboard, 6 inch, for the head fixation</a><br><code>breadboard_headplate.png</code><br>Round breadboard, 6 inch, for the head fixation</td>
</tr>
</table>
