spout-task/hardware/motorized_manipulator/design/files/box_mounting_steppermotor_drivers.pdf

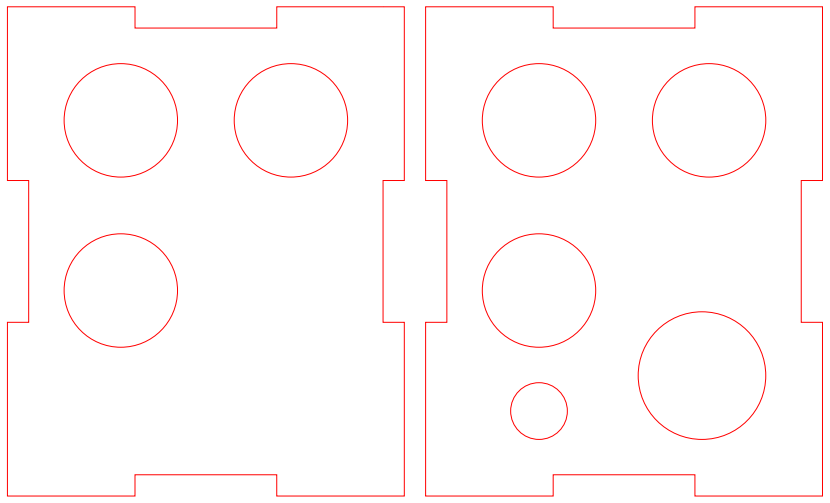
[picture p62: figure]
