spout-task/hardware/breadboards/design/files/breadboard_12x18.step

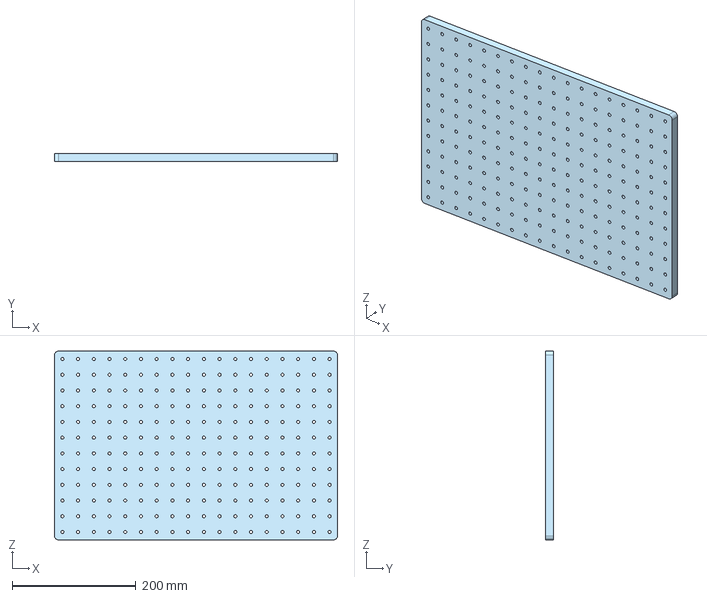
[picture p64: CAD file, 2026-11-12]
breadboards/design/files/breadboard_12x18.step
457.2 x 12.7 x 304.8 mm
