spout-task/hardware/dual_lick_detector/design/files/box_dual_lick_detector.step

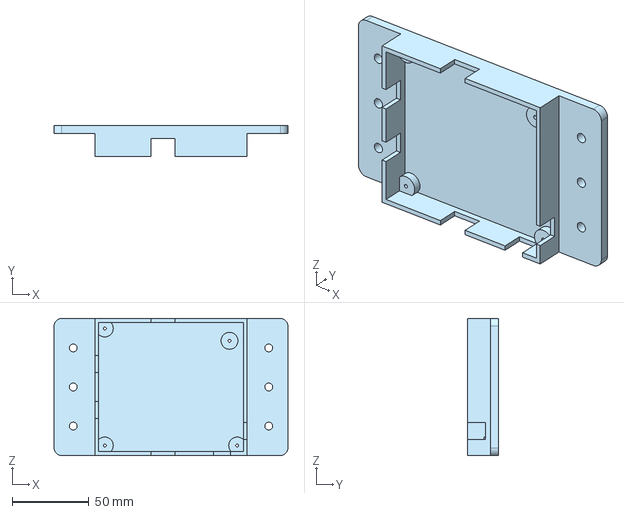
[picture p65: CAD file, 2026-11-12]
dual_lick_detector/design/files/box_dual_lick_detector.step
152.0 x 20.0 x 89.0 mm
