spout-task/hardware/head-restrained_setup/design/files/headplate_2pimaging_15degreesramp_right.step

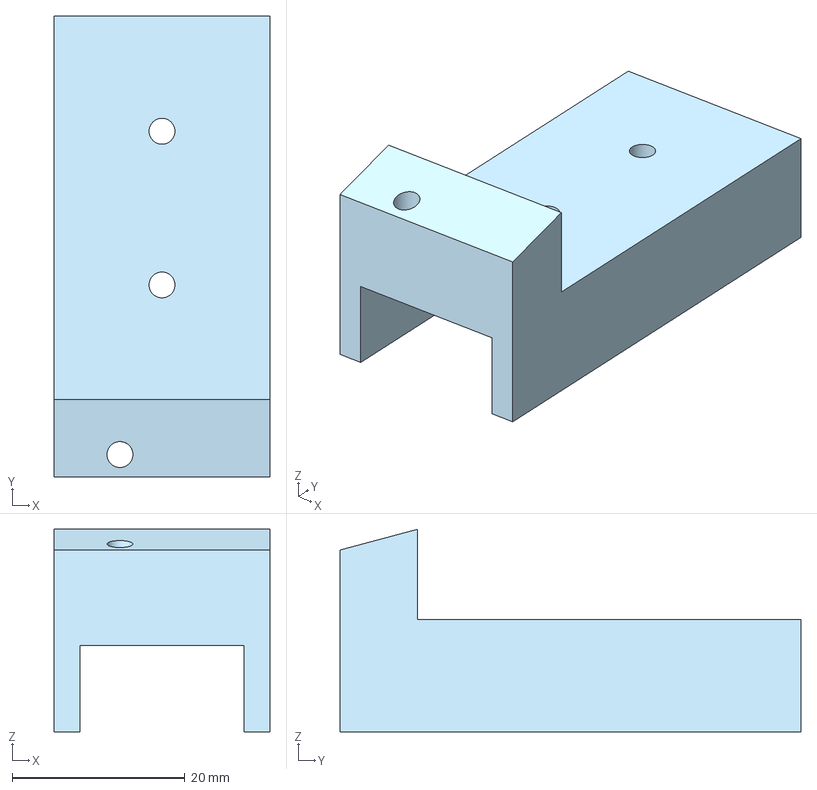
[picture p66: CAD file, 2026-11-12]
head-restrained_setup/design/files/headplate_2pimaging_15degreesramp_right.step
25.0 x 53.4 x 23.5 mm
