spout-task/hardware/housing_miscellaneous/design/files/box_power_small_sparkfun_breadboard.step

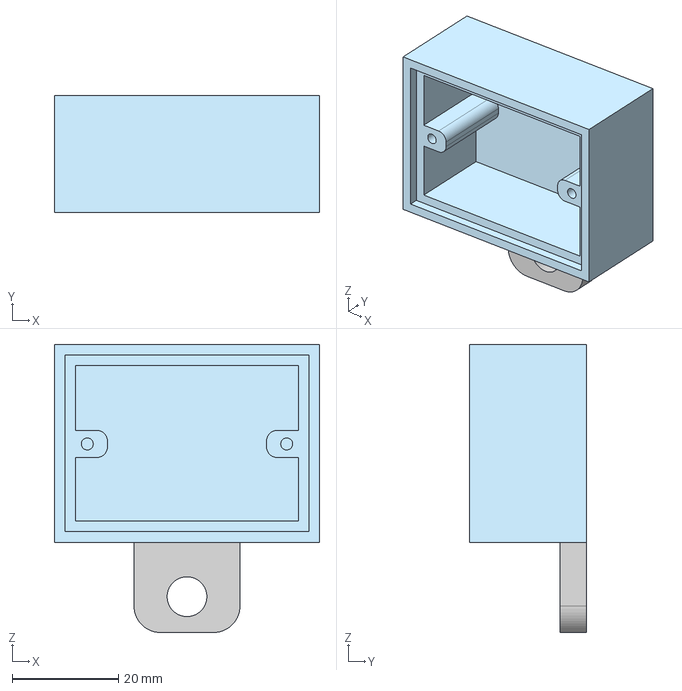
[picture p67: CAD file, 2026-11-12]
housing_miscellaneous/design/files/box_power_small_sparkfun_breadboard.step
50.0 x 22.0 x 54.3 mm
