spout-task/hardware/spout_holder/design/files/water_spout_side_mount.step

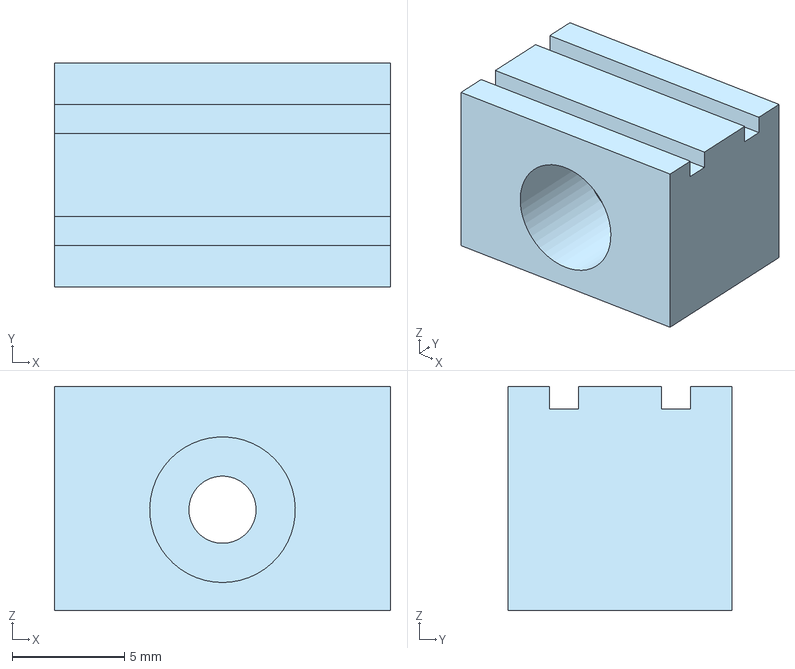
[picture p69: CAD file, 2026-11-12]
spout_holder/design/files/water_spout_side_mount.step
15.0 x 10.0 x 10.0 mm
