spout-task/hardware/teensy_breakout_board/design/files/box_teensy_breakoutboard.step

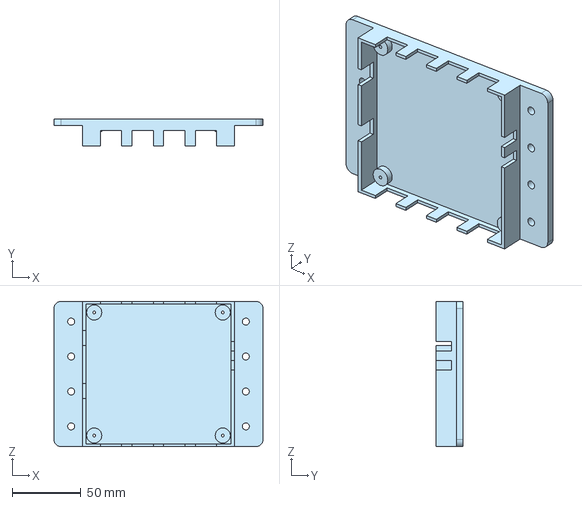
[picture p70: CAD file, 2026-11-12]
teensy_breakout_board/design/files/box_teensy_breakoutboard.step
152.0 x 20.0 x 105.5 mm
