spout-task/hardware/breadboards/design/files/breadboard_headplate.step

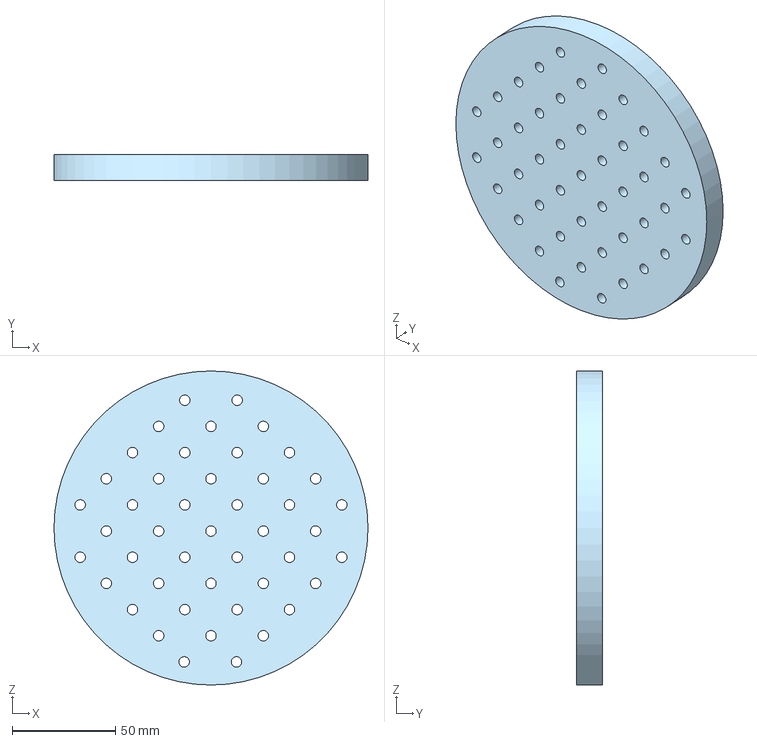
[picture p71: CAD file, 2026-11-12]
breadboards/design/files/breadboard_headplate.step
152.4 x 12.7 x 152.4 mm
