spout-task/hardware/head-restrained_setup/design/files/headplate_2pimaging.step

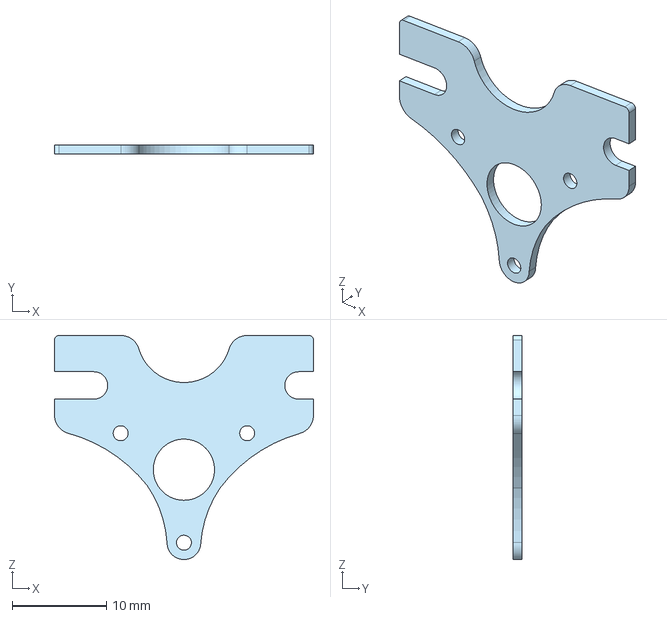
[picture p72: CAD file, 2026-11-12]
head-restrained_setup/design/files/headplate_2pimaging.step
27.5 x 1.00 x 23.8 mm
