spout-task/hardware/housing_miscellaneous/design/files/box_drok_amplifier.step

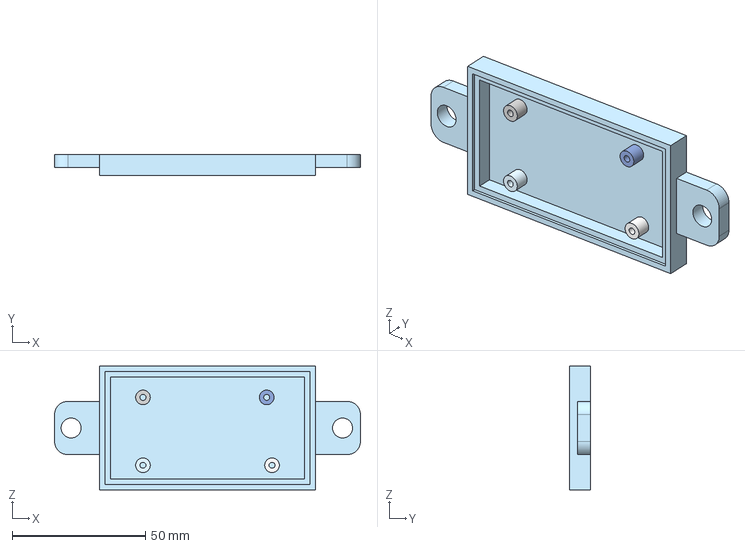
[picture p73: CAD file, 2026-11-12]
housing_miscellaneous/design/files/box_drok_amplifier.step
115.0 x 8.00 x 46.5 mm
