spout-task/hardware/motorized_manipulator/design/files/micromanipulator_to_breadboard.step

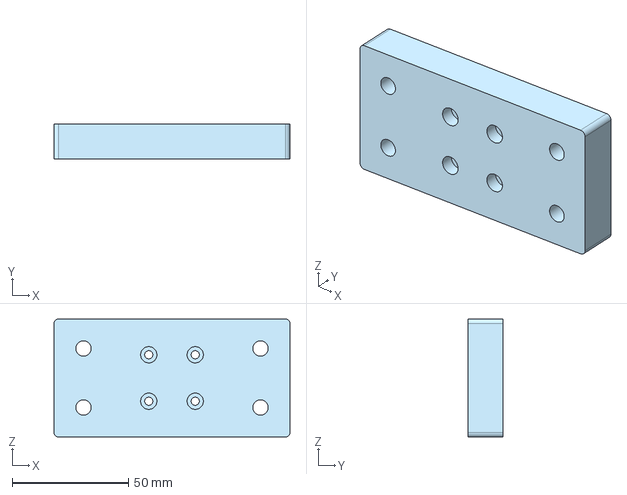
[picture p74: CAD file, 2026-11-12]
motorized_manipulator/design/files/micromanipulator_to_breadboard.step
101.6 x 15.0 x 50.8 mm
