spout-task/hardware/head-restrained_setup/design/files/headplate_behavior.step

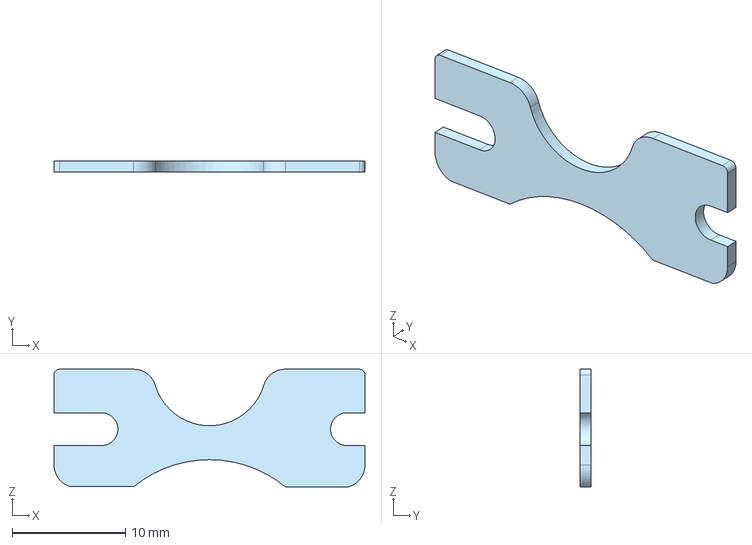
[picture p75: CAD file, 2026-11-12]
head-restrained_setup/design/files/headplate_behavior.step
27.5 x 1.00 x 10.4 mm
