spout-task/hardware/motorized_manipulator/design/files/template_linear_track_holes-5cm.step

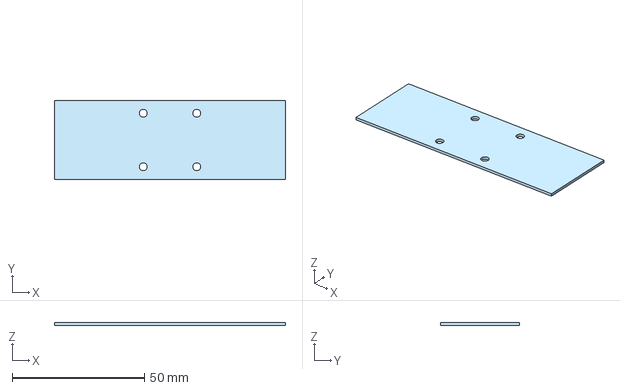
[picture p76: CAD file, 2026-11-12]
motorized_manipulator/design/files/template_linear_track_holes-5cm.step
87.2 x 30.0 x 1.00 mm
