spout-task/hardware/spout_holder/design/files/dual_solenoid_holder.step

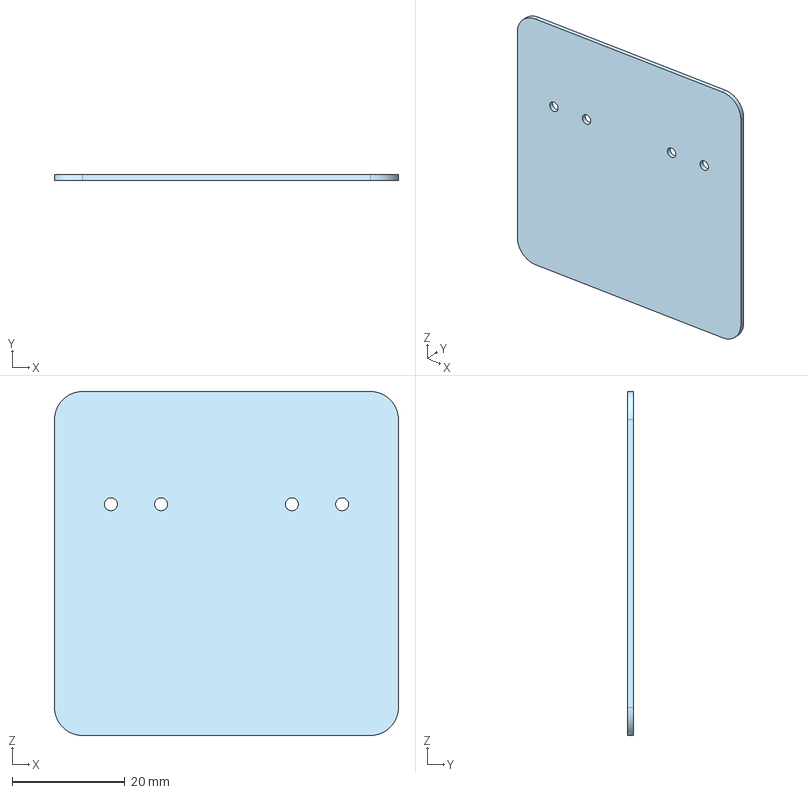
[picture p77: CAD file, 2026-11-12]
spout_holder/design/files/dual_solenoid_holder.step
61.0 x 1.00 x 61.0 mm
