spout-task/hardware/head-restrained_setup/design/files/headplate_behavior_holder_left.step

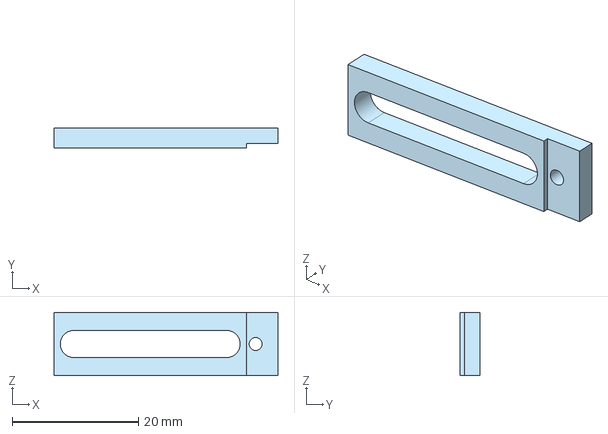
[picture p78: CAD file, 2026-11-12]
head-restrained_setup/design/files/headplate_behavior_holder_left.step
35.5 x 3.20 x 10.0 mm
