spout-task/hardware/motorized_manipulator/design/files/micromanipulator_stage2postHalfInch.step

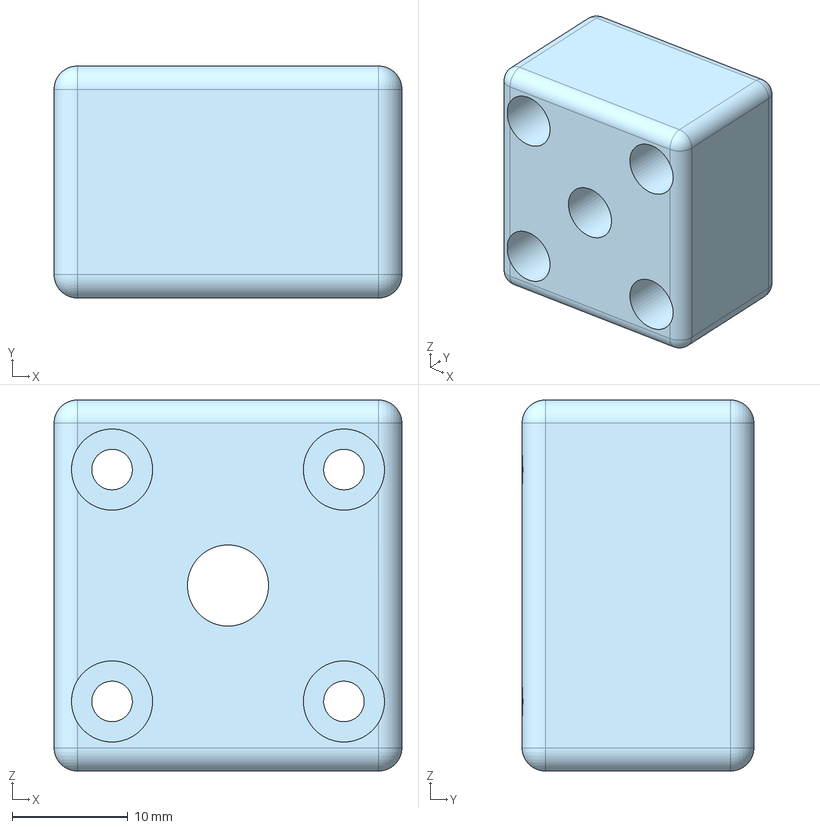
[picture p79: CAD file, 2026-11-12]
motorized_manipulator/design/files/micromanipulator_stage2postHalfInch.step
30.0 x 20.0 x 32.0 mm
