spout-task/hardware/head-restrained_setup/design/files/headplate_2pimaging_cone.step

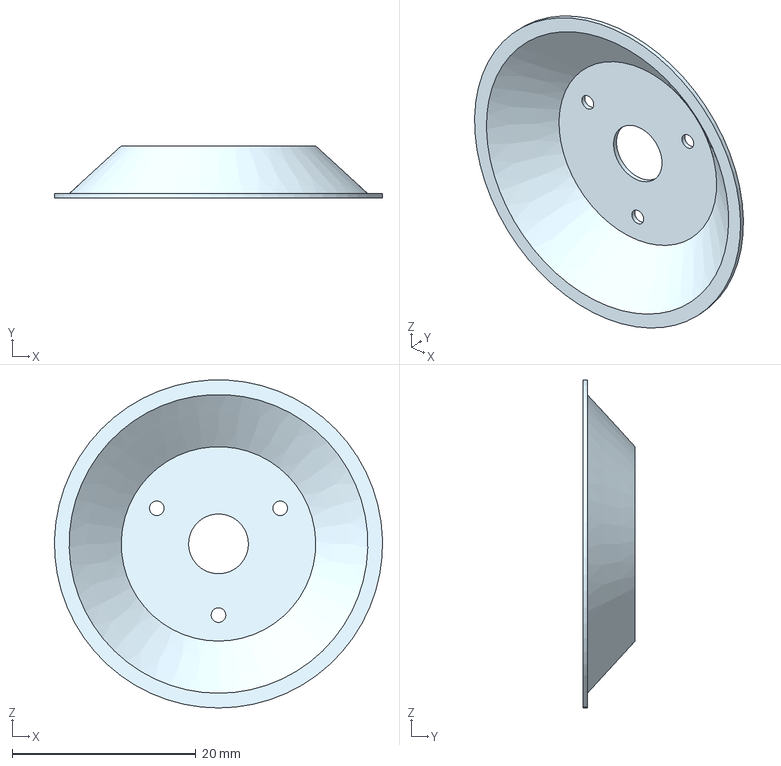
[picture p80: CAD file, 2026-11-12]
head-restrained_setup/design/files/headplate_2pimaging_cone.step
35.7 x 5.70 x 35.7 mm
