spout-task/hardware/motorized_manipulator/design/files/template_linear_track_holes-edge.step

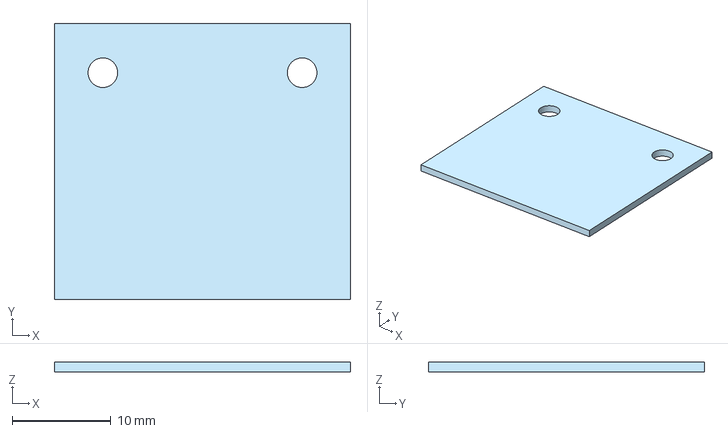
[picture p81: CAD file, 2026-11-12]
motorized_manipulator/design/files/template_linear_track_holes-edge.step
30.0 x 28.0 x 1.00 mm
