spout-task/hardware/head-restrained_setup/design/files/headplate_2pimaging_holder_big.step

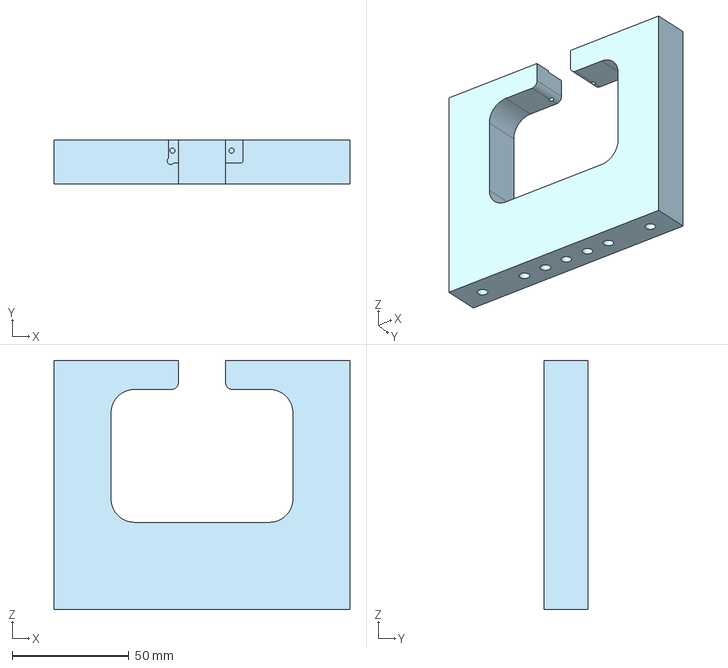
[picture p82: CAD file, 2026-11-12]
head-restrained_setup/design/files/headplate_2pimaging_holder_big.step
127.0 x 19.0 x 107.0 mm
