spout-task/hardware/motorized_manipulator/design/files/template_linear_track_holes-10cm.step

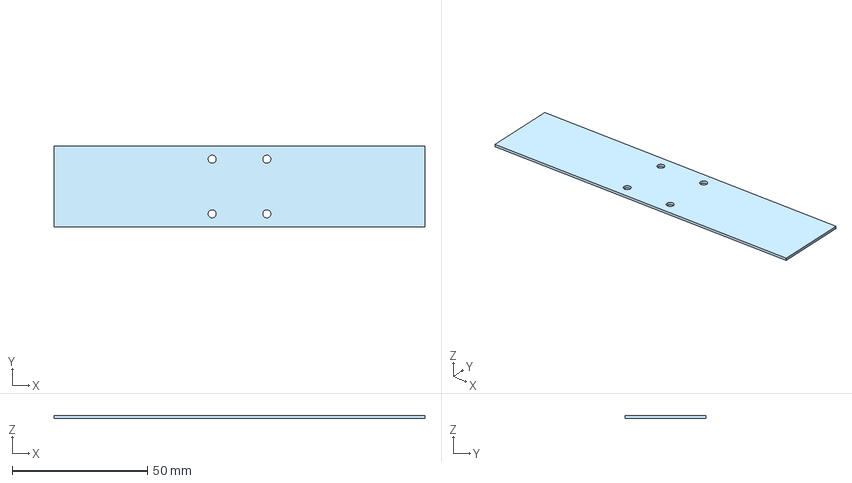
[picture p83: CAD file, 2026-11-12]
motorized_manipulator/design/files/template_linear_track_holes-10cm.step
137.1 x 30.0 x 1.00 mm
