spout-task/hardware/head-restrained_setup/design/files/headplate_2pimaging_15degreesramp_left.step

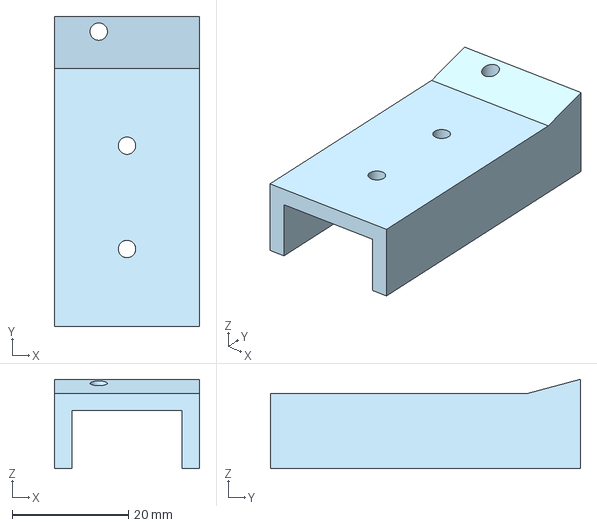
[picture p84: CAD file, 2026-11-12]
head-restrained_setup/design/files/headplate_2pimaging_15degreesramp_left.step
25.0 x 53.4 x 15.4 mm
