spout-task/hardware/head-restrained_setup/design/files/headplate_2pimaging_cover.step

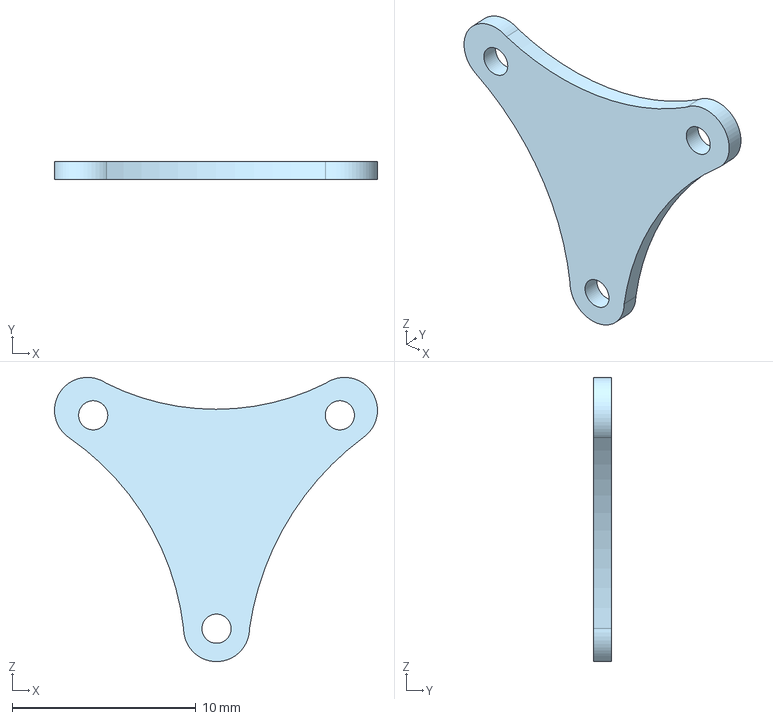
[picture p85: CAD file, 2026-11-12]
head-restrained_setup/design/files/headplate_2pimaging_cover.step
17.6 x 1.00 x 15.5 mm
