spout-task/hardware/head-restrained_setup/design/files/headplate_behavior_15degreesramp_right.step

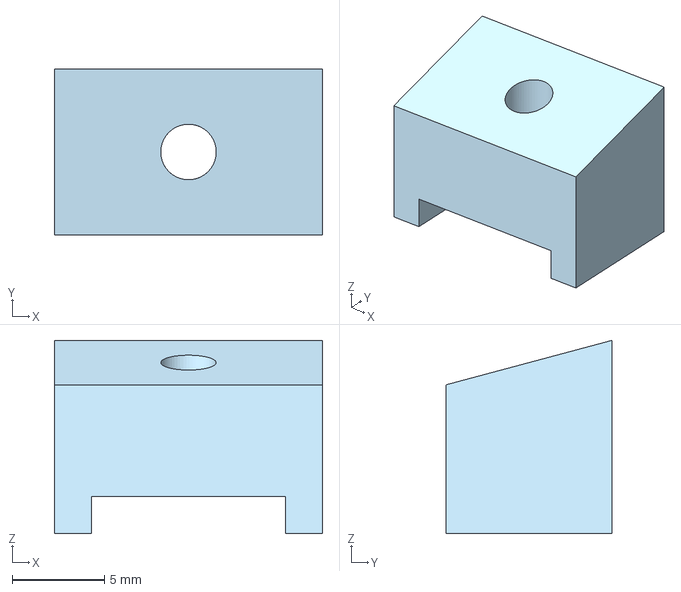
[picture p87: CAD file, 2026-11-12]
head-restrained_setup/design/files/headplate_behavior_15degreesramp_right.step
14.5 x 9.00 x 10.5 mm
