spout-task/hardware/(list of files, cad)

Other CAD files:
optogenetics_power_modulator/design/files/housing_opto_power_mod.step
spout_holder/design/files/water_spout_bottom_mount.step
breadboards/design/files/breadboard_12x18.dxf
breadboards/design/files/breadboard_12x18.stl
breadboards/design/files/breadboard_headplate.dxf
breadboards/design/files/breadboard_headplate.stl
dual_lick_detector/design/files/box_dual_lick_detector.stl
head-restrained_setup/design/files/headplate_2pimaging.dxf
head-restrained_setup/design/files/headplate_2pimaging.stl
head-restrained_setup/design/files/headplate_2pimaging_15degreesramp_left.stl
head-restrained_setup/design/files/headplate_2pimaging_15degreesramp_right.stl
head-restrained_setup/design/files/headplate_2pimaging_cone.stl
head-restrained_setup/design/files/headplate_2pimaging_cover.dxf
head-restrained_setup/design/files/headplate_2pimaging_cover.stl
head-restrained_setup/design/files/headplate_2pimaging_holder_big.stl
head-restrained_setup/design/files/headplate_behavior.dxf
head-restrained_setup/design/files/headplate_behavior.stl
head-restrained_setup/design/files/headplate_behavior_15degreesramp_right.stl
head-restrained_setup/design/files/headplate_behavior_holder_left.stl
head-restrained_setup/design/files/headplate_behavior_holder_right.stl
housing_miscellaneous/design/files/box_drok_amplifier.stl
housing_miscellaneous/design/files/box_power_small_sparkfun_breadboard.stl
motorized_manipulator/design/files/micromanipulator_stage2postHalfInch.stl
motorized_manipulator/design/files/micromanipulator_stage2postQuarterInch.stl
motorized_manipulator/design/files/micromanipulator_to_breadboard.stl
motorized_manipulator/design/files/template_linear_track_holes-10cm.dxf
motorized_manipulator/design/files/template_linear_track_holes-10cm.stl
motorized_manipulator/design/files/template_linear_track_holes-5cm.dxf
motorized_manipulator/design/files/template_linear_track_holes-5cm.stl
motorized_manipulator/design/files/template_linear_track_holes-edge.dxf
motorized_manipulator/design/files/template_linear_track_holes-edge.stl
optogenetics_power_modulator/design/files/housing_opto_power_mod.stl
spout_holder/design/files/dual_solenoid_holder.dxf
spout_holder/design/files/dual_solenoid_holder.stl
spout_holder/design/files/water_spout_bottom_mount.stl
spout_holder/design/files/water_spout_side_mount.stl
teensy_breakout_board/design/files/box_teensy_breakoutboard.stl
