spout-task/hardware/dual_lick_detector/PCB/files/dual_lick_detector_.kicad_pcb

## KiCad design dual_lick_detector/PCB/files/dual_lick_detector_.kicad_pcb (2026-11-12)

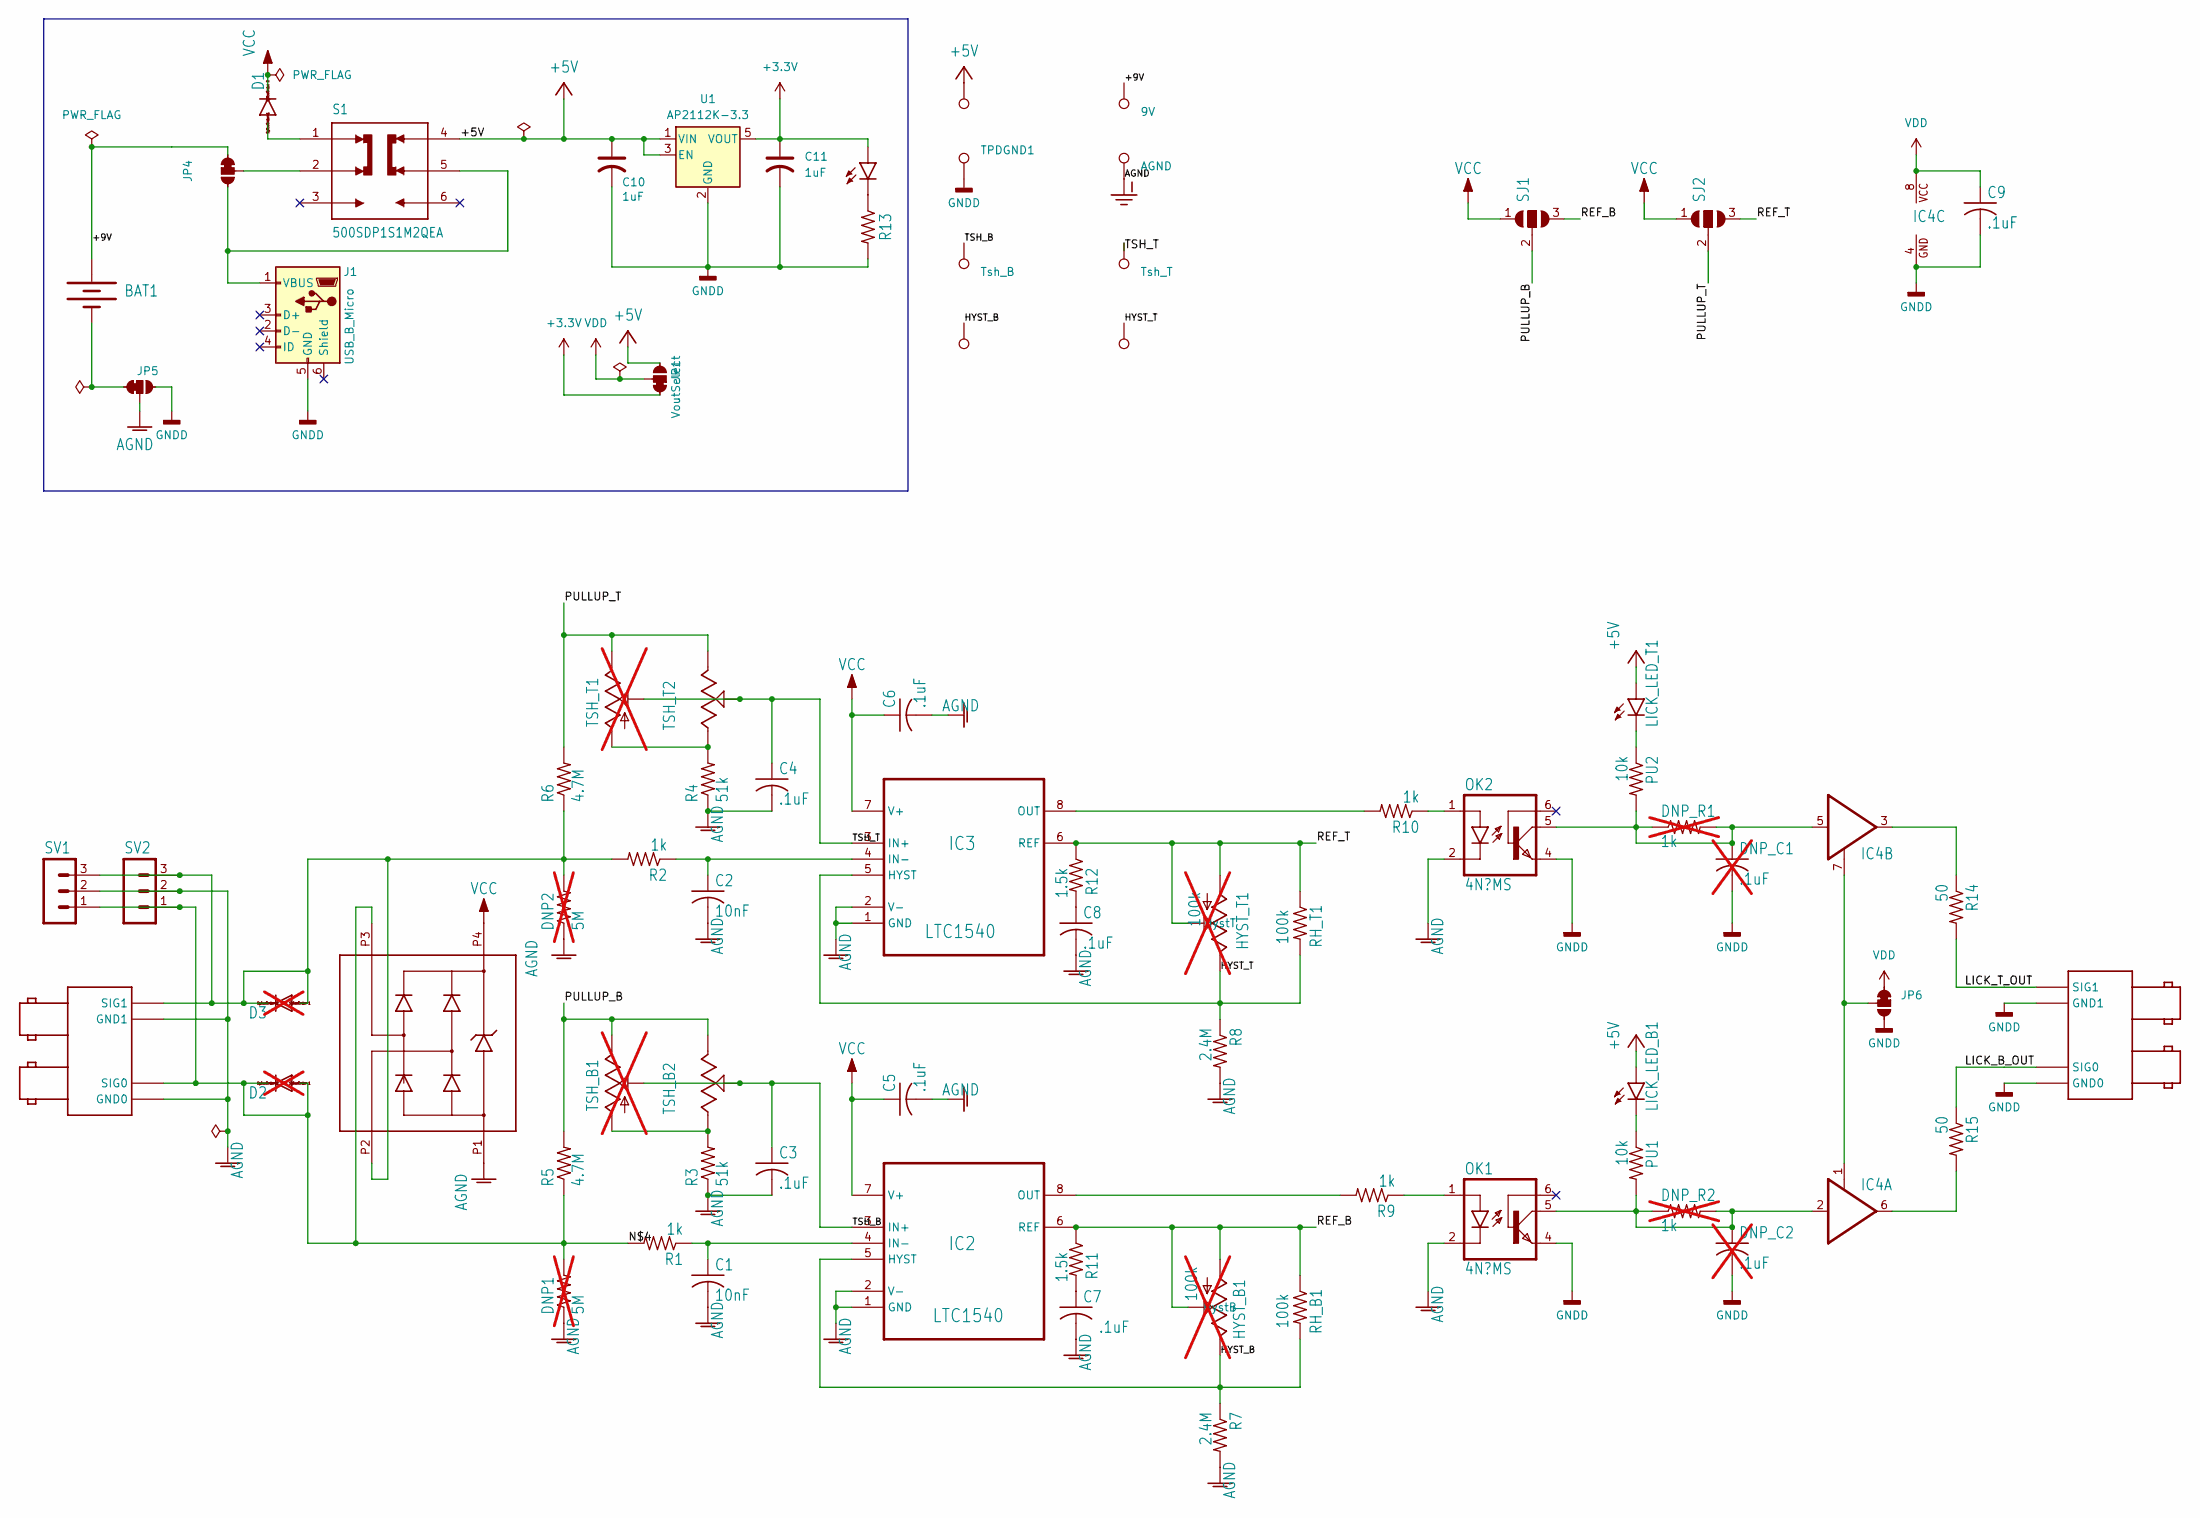
[picture p88: schematic dual_lick_detector_.kicad_sch, Lick Sensor A1e]

Parts:
BAT1: BATTERY9V; BATTCON_9V
C1, C2: 10nF; C0805
C3, C4, C5, C6, C7, C8, C9: .1uF; C0805
C10, C11: 1uF; C0805
D1: DIODE-DO-214AC; DO-214AC
D2, D3: DIODE-D-2.5; D-2.5; not fitted
DNP1, DNP2: 5M; M0805; not fitted
DNP_C1, DNP_C2: .1uF; C0805; not fitted
DNP_R1, DNP_R2: 1k; M0805; not fitted
HYST_B1: 100k; B25P; not fitted
HYST_T1: 100k; B25P; not fitted
IC1: CD143A-12_TVS; SOT-143
IC2, IC3: LTC1540; SOIC127P600X175-8N
IC4: SN74LVC2G126DCT; DCT_R-PDSO-G8
J1: USB_B_Micro; USB_Micro-B_Amphenol_10103594-0001LF_Horizontal
JP1: VoutSelect; Jumper_3_NC-1_Trace_NoSilk
JP4, JP5, JP6: Jumper_3_NC-1_Trace_NoSilk
LICKS_IN1: Licks_In; BNC_RIGHT_ANGLE_DOUBLE
LICKS_OUT1: Licks_Out; BNC_RIGHT_ANGLE_DOUBLE
LICK_LED_B1: BLick_LED; CHIPLED_0805
LICK_LED_T1: TLick_LED; CHIPLED_0805
OK1, OK2: 4N?MS; DIL6-SMD
PU1, PU2: 10k; M0805
PWR_LED1: PWR; CHIP-LED0805
R1, R2, R9, R10, R13: 1k; M0805
R3, R4: 51k; M0805
R5, R6: 4.7M; M0805
R7, R8: 2.4M; M0805
R11, R12: 1.5k; M0805
R14, R15: 50; M0805
RH_B1: 100k; M0805
RH_T1: 100k; M0805
S1: 500SDP1S1M2QEA; SW_500SDP1S1M2QEA
SJ1, SJ2: SJ2W; SJ_2
SV1, SV2: MA03-1
TP5V1: 5V; TestPoint_THTPad_2.0x2.0mm_Drill1.0mm
TP9V1: 9V; TestPoint_THTPad_2.0x2.0mm_Drill1.0mm
TPAGND1: AGND; TestPoint_THTPad_2.0x2.0mm_Drill1.0mm
TPDGND1: DGND; TestPoint_THTPad_2.0x2.0mm_Drill1.0mm
TP_Hyst_B1: Hyst_B; TestPoint_THTPad_D2.0mm_Drill1.0mm
TP_Hyst_T1: Hyst_T; TestPoint_THTPad_D2.0mm_Drill1.0mm
TP_TSH_B1: Tsh_B; TestPoint_THTPad_D2.0mm_Drill1.0mm
TP_TSH_T1: Tsh_T; TestPoint_THTPad_D2.0mm_Drill1.0mm
TSH_B1: 100k; B25P; not fitted
TSH_B2: 3590S-2-103L; TRIM_3590S-2-103L
TSH_T1: 100k; B25P; not fitted
TSH_T2: 3590S-2-103L; TRIM_3590S-2-103L
U1: AP2112K-3.3; SOT-23-5

Connections:
+3.3V: C11.1, JP1.1 (A), PWR_LED1.A, U1.5 (VOUT)
+5V: C10.1, JP1.3 (C), LICK_LED_B1.A, LICK_LED_T1.A, S1.4, TP5V1.1, U1.1 (VIN), U1.3 (EN)
/+9V: BAT1.+, JP4.1 (A), TP9V1.1
/HYST_B: HYST_B1.E, IC2.5 (HYST), R7.1, RH_B1.2, TP_Hyst_B1.1
/HYST_T: HYST_T1.E, IC3.5 (HYST), R8.1, RH_T1.2, TP_Hyst_T1.1
/LICK_B_OUT: LICKS_OUT1.P$SIG0 (SIG0), R15.1
/LICK_T_OUT: LICKS_OUT1.P$SIG1 (SIG1), R14.2
/N$4: D2.A, D2.C, DNP1.2, IC1.P3, LICKS_IN1.P$SIG0 (SIG0), R1.2, R5.1, SV1.1, SV2.1
/PULLUP_B: R5.2, SJ1.2, TSH_B1.E, TSH_B2.3 (CW)
/PULLUP_T: R6.2, SJ2.2, TSH_T1.E, TSH_T2.3 (CW)
/REF_B: HYST_B1.A, HYST_B1.S, IC2.6 (REF), R11.1, RH_B1.1, SJ1.3
/REF_T: HYST_T1.A, HYST_T1.S, IC3.6 (REF), R12.1, RH_T1.1, SJ2.3
/TSH_B: C3.1, IC2.3 (IN+), TP_TSH_B1.1, TSH_B1.S, TSH_B2.2 (WIPER)
/TSH_T: C4.1, IC3.3 (IN+), TP_TSH_T1.1, TSH_T1.S, TSH_T2.2 (WIPER)
AGND: C1.2, C2.2, C3.2, C4.2, C5.2, C6.2, C7.2, C8.2, DNP1.1, DNP2.1, IC1.P1, IC2.1 (GND), IC2.2 (V-), IC3.1 (GND), IC3.2 (V-), JP5.2 (B), LICKS_IN1.P$GND0 (GND0), LICKS_IN1.P$GND1 (GND1), OK1.2 (C), OK2.2 (C), R3.1, R4.1, R7.2, R8.2, SV1.2, SV2.2, TPAGND1.1
GNDD: C9.2, C10.2, C11.2, DNP_C1.2, DNP_C2.2, IC4.4 (GND), J1.5 (GND), JP5.3 (C), JP6.3 (C), LICKS_OUT1.P$GND0 (GND0), LICKS_OUT1.P$GND1 (GND1), OK1.4 (EMI), OK2.4 (EMI), R13.2, TPDGND1.1, U1.2 (GND); also elsewhere on the board
unnamed: C7.1, R11.2
unnamed: C8.1, R12.2
unnamed: D1.A, S1.1
unnamed: D3.A, D3.C, DNP2.2, IC1.P2, LICKS_IN1.P$SIG1 (SIG1), R2.2, R6.1, SV1.3, SV2.3
unnamed: C1.1, IC2.4 (IN-), R1.1
unnamed: IC2.8 (OUT), R9.2
unnamed: C2.1, IC3.4 (IN-), R2.1
unnamed: IC3.8 (OUT), R10.2
unnamed: DNP_C2.1, DNP_R2.1, DNP_R2.2, IC4.2 (I), OK1.5 (COL), PU1.2
unnamed: IC4.6 (O), R15.2
unnamed: IC4.1 (OE), IC4.7 (OE), JP6.2 (B)
unnamed: DNP_C1.1, DNP_R1.1, DNP_R1.2, IC4.5 (I), OK2.5 (COL), PU2.2
unnamed: IC4.3 (O), R14.1
unnamed 29: J1.1 (VBUS), JP4.3 (C), S1.5; also elsewhere on the board
unnamed: JP4.2 (B), S1.2
unnamed: BAT1.-, JP5.1 (A)
unnamed: LICK_LED_B1.C, PU1.1
unnamed: LICK_LED_T1.C, PU2.1
unnamed: OK1.1 (A), R9.1
unnamed: OK2.1 (A), R10.1
unnamed: PWR_LED1.C, R13.1
unnamed: R3.2, TSH_B1.A, TSH_B2.1 (CCW)
unnamed: R4.2, TSH_T1.A, TSH_T2.1 (CCW)
VCC: C5.1, C6.1, D1.C, IC1.P4, IC2.7 (V+), IC3.7 (V+), SJ1.1, SJ2.1
VDD: C9.1, IC4.8 (VCC), JP1.2 (B), JP6.1 (A)

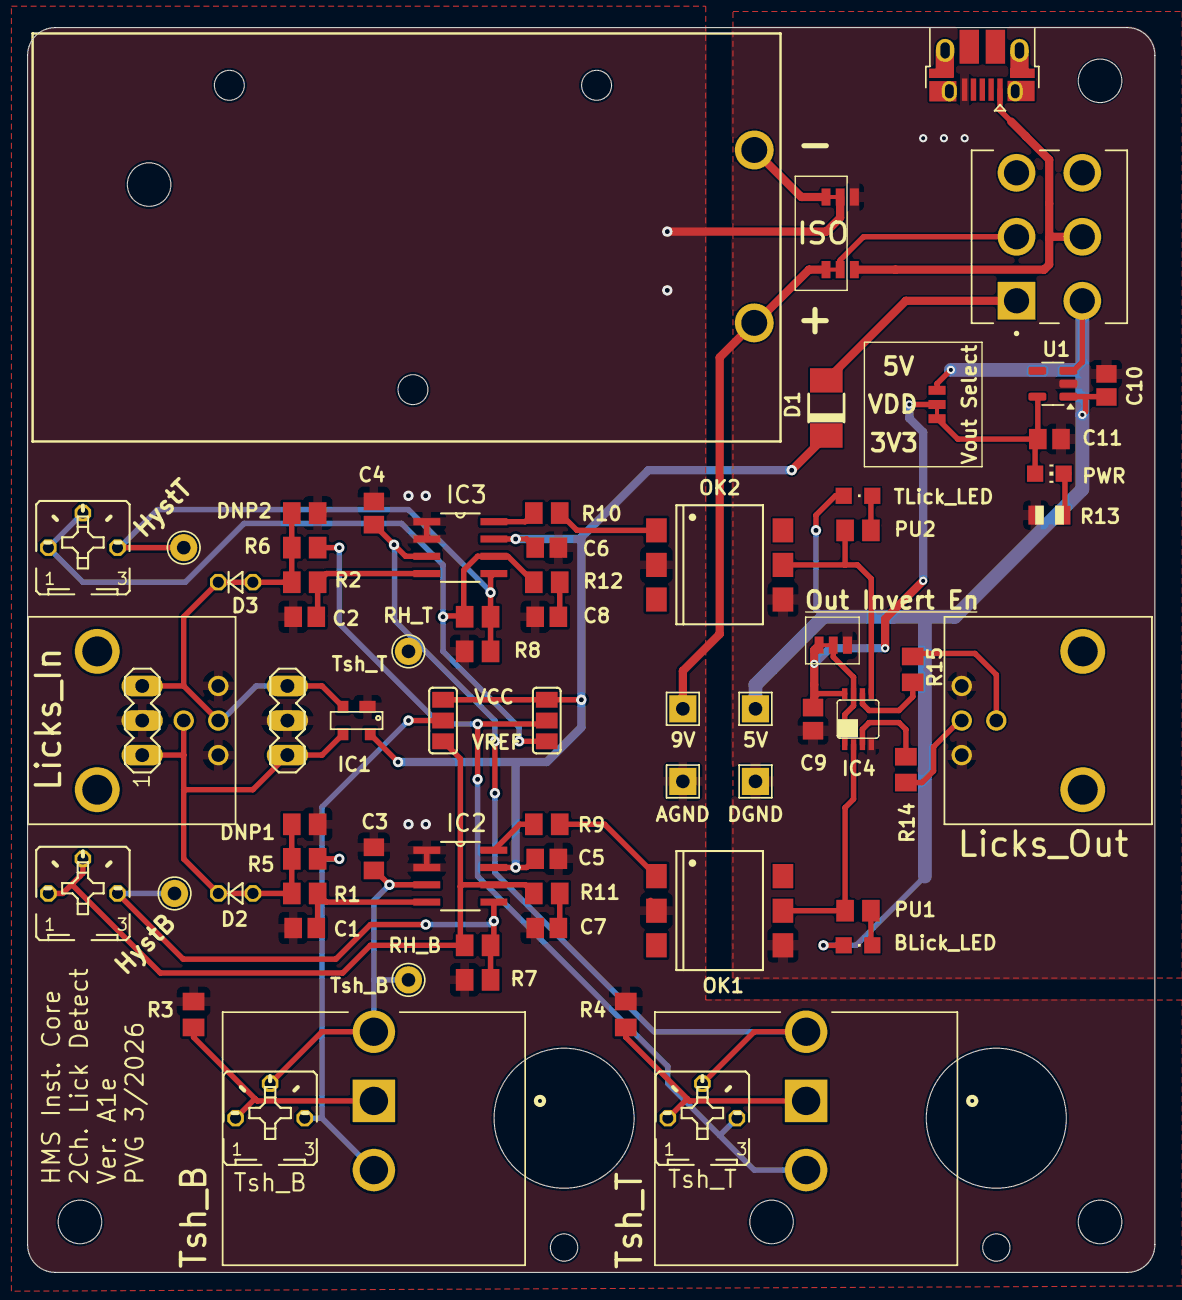
[picture p89: board dual_lick_detector_.kicad_pcb from above]

Board: 2 copper layers, 82.8 x 91.4 mm, 82 parts (1 on the bottom side), 41 nets.

Other parts of the board:
@HOLE0, @HOLE1, @HOLE2, @HOLE3, @HOLE4, @HOLE5, @HOLE6, @HOLE7, @HOLE8: (no value)
J2: USB_B_Micro; USB_Micro-B_Amphenol_10103594-0001LF_Horizontal
U$7: RIC_LOGO_BIG

Their connections:
GNDD: J2.5 (GND); also elsewhere on the board
unnamed 29: J2.1 (VBUS); also elsewhere on the board
