spout-task/hardware/teensy_breakout_board/PCB/files/Teensy_breakout_board.kicad_pcb

## KiCad design teensy_breakout_board/PCB/files/Teensy_breakout_board.kicad_pcb (2026-11-12)

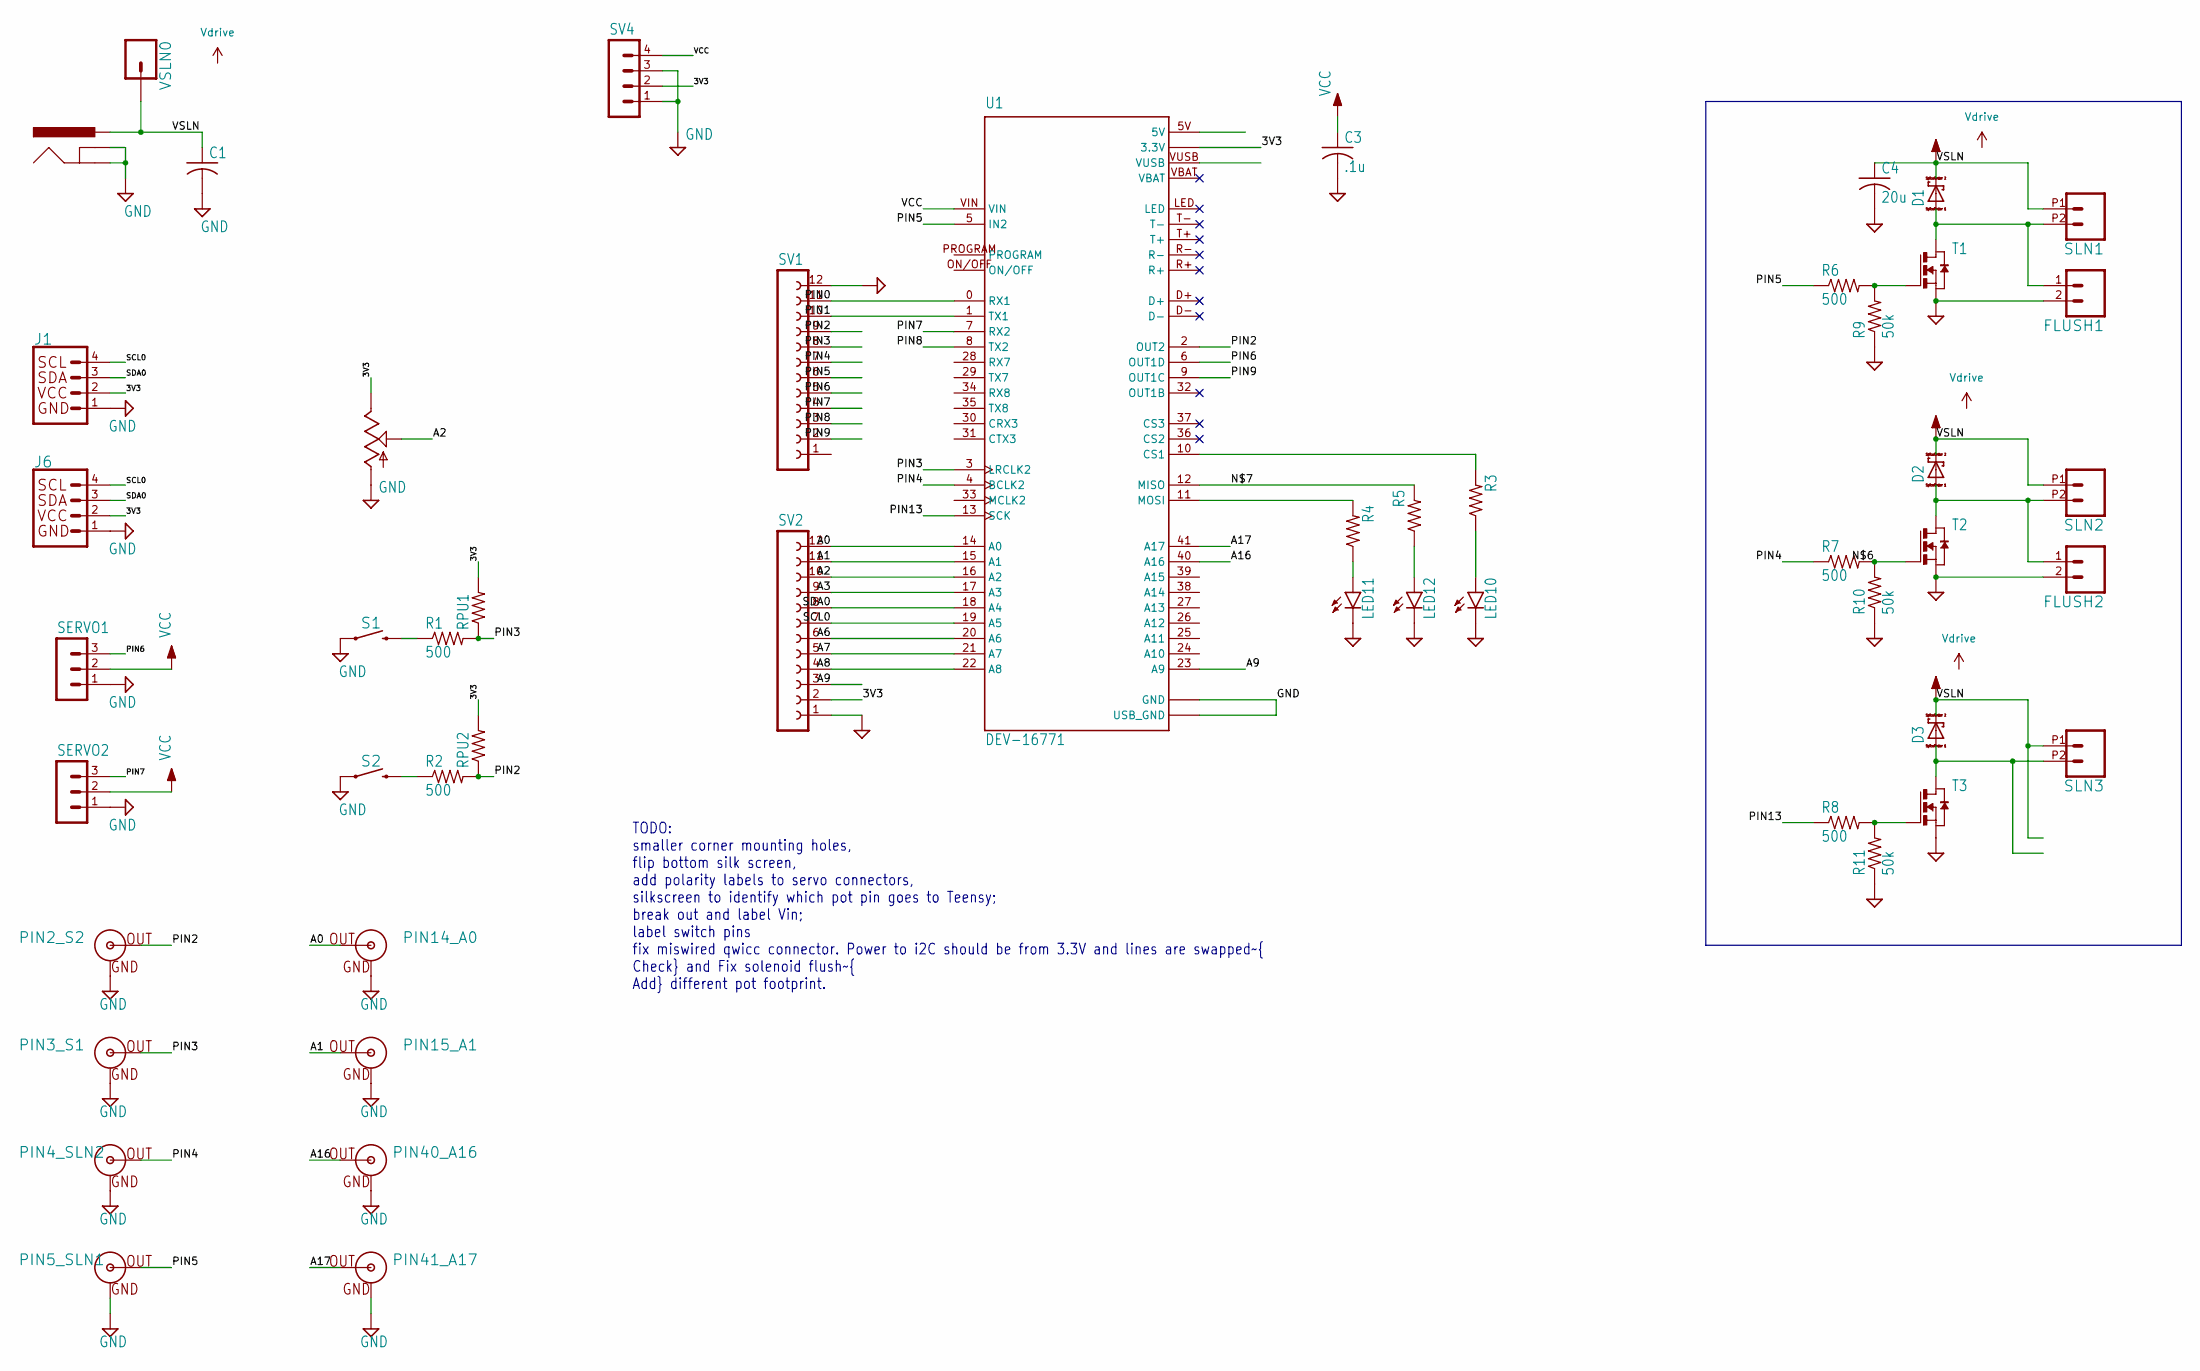
[picture p90: schematic Teensy_breakout_board.kicad_sch, General Purpose Teensy breakout]

Parts:
C1: C-US025-024X044; C025-024X044
C3: .1u; C0805K
C4: 20u; C025-040X050
D1, D2, D3: SCHOTTKY-DIODE; DIODE_SMB
FLUSH1, FLUSH2: CONN_02PTH4; 1X02_XTRA_BIG
J1, J6: QWIIC_CONNECTORJS-1MM; 1X04_1MM_RA
J2: POWER_JACK; POWER_JACK_PTH
LED10, LED11, LED12: LEDSFH482; SFH482
PIN2_S2, PIN3_S1, PIN4_SLN2, PIN5_SLN1, PIN14_A0, PIN15_A1, PIN40_A16, PIN41_A17: BNCPTH; BNC
R1, R2: 500; 0207_2V
R3, R4, R5: R-US_0207/2V; 0207_2V
R6, R7, R8: 500; M1206
R9, R10, R11: 50k; M1206
RPU1, RPU2: R-US_0207/2V; 0207_2V
S1, S2: MOMENTARY-SWITCH-SPST-PTH-12MM; TACTILE_SWITCH_PTH_12MM
SERVO1, SERVO2: MA03-1
SLN1, SLN2, SLN3: CONN_022.54MM_SCREWTERM; 1X02_2.54_SCREWTERM
SV1, SV2: FE12-1; FE12
SV4: MA04-1
T1, T2, T3: NMOSSOT223; SOT223
U1: DEV-16771; MODULE_DEV-16771
U$2: POTENTIOMETER; BOURNS_12MM_POTENTIOMETER_VERT
VSLN0: CONN_01; 1X01

Connections:
3V3: J1.2 (VCC), J6.2 (VCC), RPU1.2, RPU2.2, SV2.2, SV4.2, U1.3.3V_1 (3.3V), U1.3.3V_2 (3.3V), U1.3.3V_3 (3.3V), U$2.P$3 (E)
A0: PIN14_A0.S (OUT), SV2.12, U1.14 (A0)
A1: PIN15_A1.S (OUT), SV2.11, U1.15 (A1)
A2: SV2.10, U1.16 (A2), U$2.P$2 (S)
A3: SV2.9, U1.17 (A3)
A6: SV2.6, U1.20 (A6)
A7: SV2.5, U1.21 (A7)
A8: SV2.4, U1.22 (A8)
A9: SV2.3, U1.23 (A9)
A16: PIN40_A16.S (OUT), U1.40 (A16)
A17: PIN41_A17.S (OUT), U1.41 (A17)
GND: C1.2, C3.2, C4.2, FLUSH1.2, FLUSH2.2, J1.1 (GND), J2.GND, J2.GNDBREAK, J6.1 (GND), LED10.K (C), LED11.K (C), LED12.K (C), PIN2_S2.GND, PIN3_S1.GND, PIN4_SLN2.GND, PIN5_SLN1.GND, PIN14_A0.GND, PIN15_A1.GND, PIN40_A16.GND, PIN41_A17.GND, R9.1, R10.1, R11.1, S1.1, S2.1, SERVO1.1, SERVO2.1, SV1.12, SV2.1, SV4.1, SV4.3, T1.3 (S), T2.3 (S), T3.3 (S), U1.GND1 (GND), U1.GND2 (GND), U1.GND3 (GND), U1.GND4 (GND), U1.GND5 (GND), U1.USB_GND1 (USB_GND), U1.USB_GND2 (USB_GND), U$2.P$1 (A)
unnamed: R1.1, S1.3 (2)
unnamed: R2.1, S2.3 (2)
unnamed: R4.2, U1.11 (MOSI)
unnamed: R3.2, U1.10 (CS1)
unnamed: LED10.A, R3.1
unnamed: R7.2, R10.2, T2.1 (G)
unnamed: R5.2, U1.12 (MISO)
unnamed: LED11.A, R4.1
unnamed: LED12.A, R5.1
unnamed: R6.2, R9.2, T1.1 (G)
unnamed: R8.2, R11.2, T3.1 (G)
PIN0: SV1.11, U1.0 (RX1)
PIN1: SV1.10, U1.1 (TX1)
PIN2: PIN2_S2.S (OUT), R2.2, RPU2.1, SV1.9, U1.2 (OUT2)
PIN3: PIN3_S1.S (OUT), R1.2, RPU1.1, SV1.8, U1.3 (LRCLK2)
PIN4: PIN4_SLN2.S (OUT), R7.1, SV1.7, U1.4 (BCLK2)
PIN5: PIN5_SLN1.S (OUT), R6.1, SV1.6, U1.5 (IN2)
PIN6: SERVO1.3, SV1.5, U1.6 (OUT1D)
PIN7: SERVO2.3, SV1.4, U1.7 (RX2)
PIN8: SV1.3, U1.8 (TX2)
PIN9: SV1.2, U1.9 (OUT1C)
PIN13: R8.1, U1.13 (SCK)
SCL0: J1.4 (SCL), J6.4 (SCL), SV2.7, U1.19 (A5)
SDA0: J1.3 (SDA), J6.3 (SDA), SV2.8, U1.18 (A4)
VOUT-1: D2.A (C), FLUSH2.1, SLN2.P2 (2), T2.2 (D), T2.4 (D)
VOUT-2: D1.A (C), FLUSH1.1, SLN1.P2 (2), T1.2 (D), T1.4 (D)
VOUT-3: D3.A (C), SLN3.P2 (2), T3.2 (D), T3.4 (D)

Notes on the sheet:
TODO: smaller corner mounting holes, flip bottom silk screen, add polarity labels to servo connectors, silkscreen to identify which pot pin goes to Teensy; break out and label Vin; label switch pins fix miswired qwicc connector. Power to i2C should be from 3.3V~{} and lines are swapped~{ Check} and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
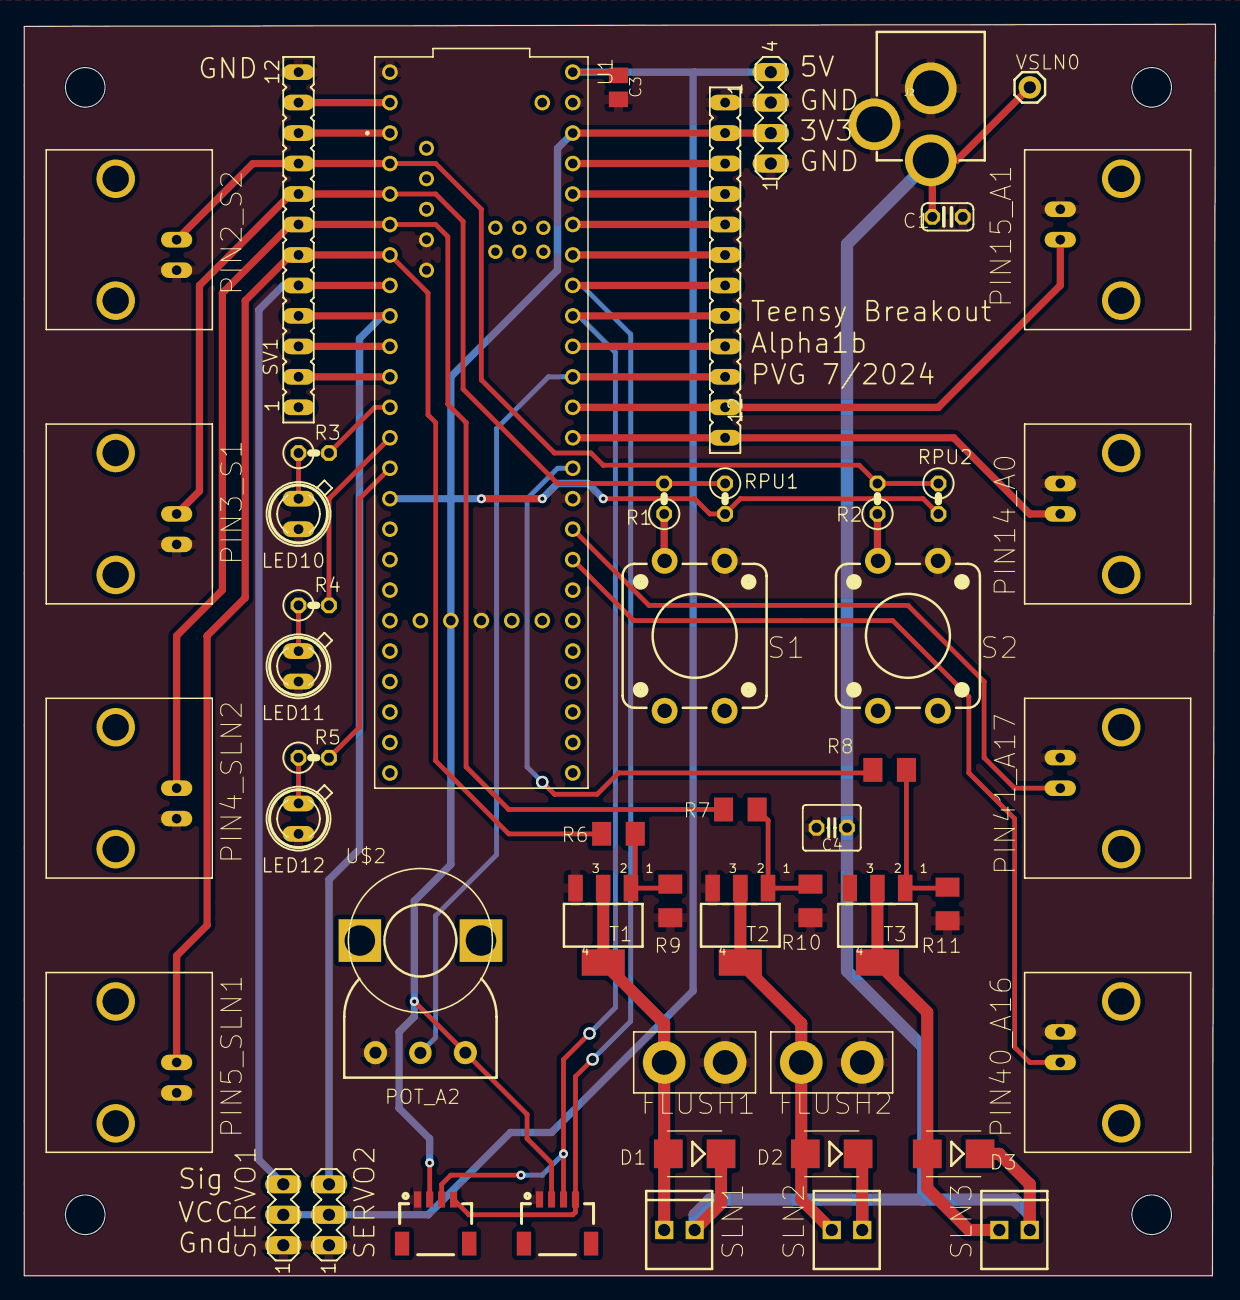
[picture p91: board Teensy_breakout_board.kicad_pcb from above]

Board: 2 copper layers, 99.3 x 104.3 mm, 55 parts (0 on the bottom side), 41 nets.

Other parts of the board:
@HOLE0, @HOLE1, @HOLE2, @HOLE3: (no value)
