spout-task/hardware/(commit log)

2026-11-11 Update README with housing details for dual-lick detector
    Added a description and usage details for the housing.
2026-11-11 Update README with design picture and printing info
    Added a picture of the design and a description of the 3D printing process.
2026-11-11 Update README with new housing design image
2026-11-11 Update README with 3D printed housing details
    Added description for 3D printed housing directory.
2026-11-11 Remove housing details from README
    Removed housing section and associated image from README.
2026-11-12 Update READMEs, BOM, file locations and firmware folders
    [SPOUT_BOM.xlsx, template_linear_track_holes-10cm.stl, template_linear_track_holes-5cm.stl, template_linear_track_holes-edge.stl]
2026-11-12 Use design folders, add DXF files, solenoid holder and manipulator schematics
    Fabrication folders (3d_printing, laser_cutting, cnc, 3d_printed_housing)
    are now design/files and design/pictures. Each README says per part how
    it was made. Adds DXF files for breadboards, headplates and drilling
    templates, the dual solenoid holder (DXF, STL, STEP), and six new
    schematics that replace the vendor pictures of the manipulator.
    [box_drok_amplifier.stl, box_dual_lick_detector.stl, box_power_small_sparkfun_breadboard.stl, box_teensy_breakoutboard.stl, breadboard_12x18.dxf, breadboard_12x18.step, breadboard_12x18.stl, breadboard_headplate.dxf]
2026-11-12 Add KiCad files and photos for both boards, STEP files for all parts
    Dual lick detector is now revision Alpha1e in KiCad 10; the EAGLE
    Alpha1d files are removed. Teensy breakout board Alpha1b is now in
    KiCad 10. New photos and board renders for both. Adds STEP files for
    every machined, printed and laser cut part, and corrected DXF files for
    the imaging headplate and cover. READMEs explain how to export
    fabrication files from KiCad.
    [ComparatorLickDet_Alpha1b.brd, ComparatorLickDet_Alpha1b.sch, ComparatorLickDet_Alpha1d.brd, ComparatorLickDet_Alpha1d.sch, HMS-2-Ch-Lick-Detector-Alpha1d_BOM_PCBWay.xlsx, Teensy_breakout_board.kicad_pcb, Teensy_breakout_board.kicad_sch, box_drok_amplifier.step]
2026-11-12 Remove table clamp mounting of the rig breadboard
2026-11-12 Add a picture gallery README to every picture folder
    Each folder with pictures now shows all of them on its GitHub page in a
    two column grid, with file name, caption and a link back to the device
    README.
2026-11-13 Link HMS RIC Teensy breakout board repository
2026-11-13 Fix typo in Teensy breakout board README
    Corrected a typo in the description of the Teensy breakout board.
2026-11-13 Update assembly instructions for breadboard setup
2026-11-13 Add photos of the rig, head restrained setup, headplates and manipulator
    SPOUT_setup.png on the main README; photos of the head restrained setup, headplates, imaging cone and assembled manipulator on the device READMEs and picture galleries.
2026-11-13 Add opto power modulator photo and rig caption
    opto_power_mod0.png is now the main picture of the optogenetics power modulator README; the circuit diagram moves to How it works. More descriptive caption for SPOUT_setup.png.
